axpaul/KinetiCoreDC/Document/KinetiCoreDC_ioc.pdf

03/11/2026

KinetiCoreDC Project
Configuration Report

## 1. Description

### 1.1. Project

Project Name | KinetiCoreDC
Board Name | custom
Generated with: | STM32CubeMX 6.15.0
Date | 11/03/2026

### 1.2. MCU

MCU Series | STM32G0
MCU Line | STM32G0x0 Value line
MCU name | STM32G070CBTx
MCU Package | LQFP48
MCU Pin number | 48

### 1.3. Core(s) information

Core(s) | ARM Cortex-M0+

## 2. Pinout Configuration

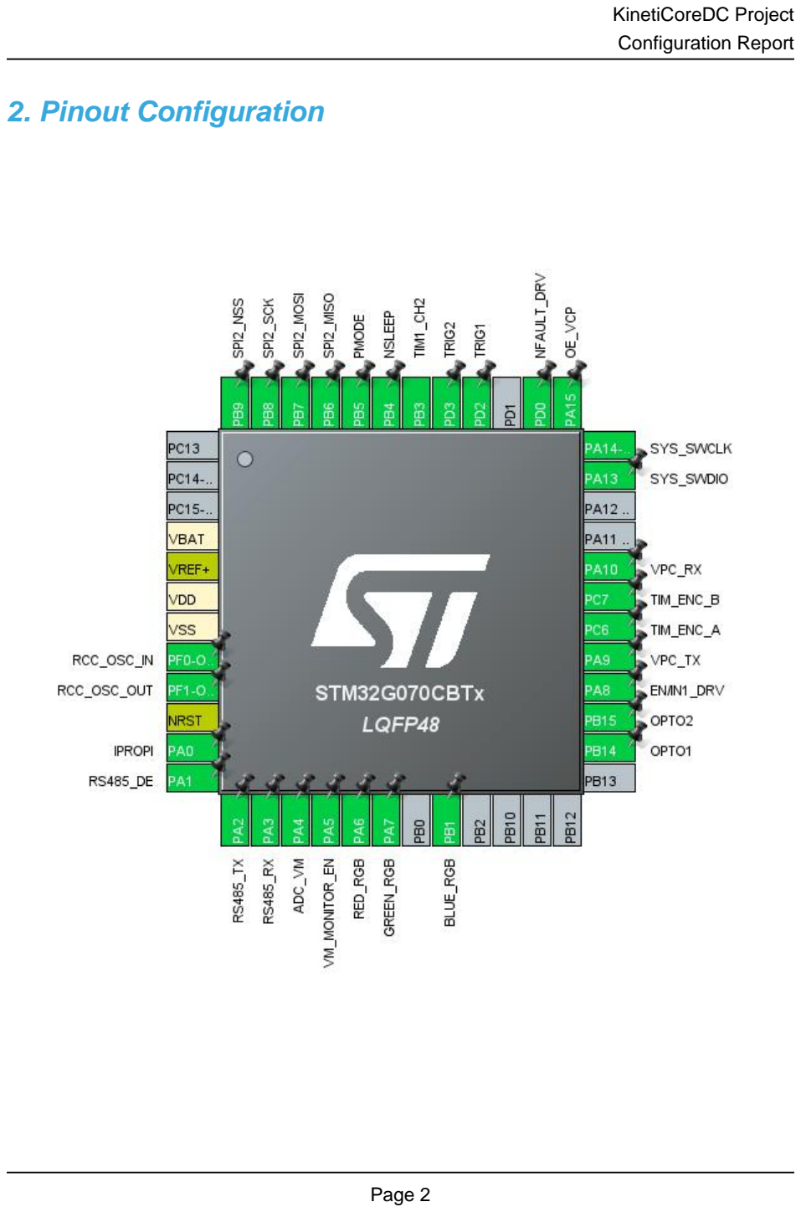
[picture p6: page 3]

## 3. Pins Configuration

Pin Number LQFP48 | Pin Name (function after reset) | Pin Type | Alternate Function(s) | Label
4 | VBAT | Power
5 | VREF+ | MonoIO
6 | VDD | Power
7 | VSS | Power
8 | PF0-OSC_IN (PF0) | I/O | RCC_OSC_IN
9 | PF1-OSC_OUT (PF1) | I/O | RCC_OSC_OUT
10 | NRST | Reset
11 | PA0 | I/O | ADC1_IN0 | IPROPI
12 | PA1 | I/O | USART2_DE | RS485_DE
13 | PA2 | I/O | USART2_TX | RS485_TX
14 | PA3 | I/O | USART2_RX | RS485_RX
15 | PA4 | I/O | ADC1_IN4 | ADC_VM
16 | PA5 * | I/O | GPIO_Output | VM_MONITOR_EN
17 | PA6 | I/O | TIM16_CH1 | RED_RGB
18 | PA7 | I/O | TIM17_CH1 | GREEN_RGB
20 | PB1 | I/O | TIM14_CH1 | BLUE_RGB
26 | PB14 | I/O | TIM15_CH1 | OPTO1
27 | PB15 | I/O | TIM15_CH2 | OPTO2
28 | PA8 | I/O | TIM1_CH1 | EN/IN1_DRV
29 | PA9 | I/O | USART1_TX | VPC_TX
30 | PC6 | I/O | TIM3_CH1 | TIM_ENC_A
31 | PC7 | I/O | TIM3_CH2 | TIM_ENC_B
32 | PA10 | I/O | USART1_RX | VPC_RX
35 | PA13 | I/O | SYS_SWDIO
36 | PA14-BOOT0 | I/O | SYS_SWCLK
37 | PA15 * | I/O | GPIO_Output | OE_VCP
38 | PD0 | I/O | GPIO_EXTI0 | NFAULT_DRV
40 | PD2 | I/O | GPIO_EXTI2 | TRIG1
41 | PD3 | I/O | GPIO_EXTI3 | TRIG2
42 | PB3 | I/O | TIM1_CH2
43 | PB4 * | I/O | GPIO_Output | NSLEEP
44 | PB5 * | I/O | GPIO_Output | PMODE
45 | PB6 | I/O | SPI2_MISO
46 | PB7 | I/O | SPI2_MOSI
47 | PB8 | I/O | SPI2_SCK
48 | PB9 | I/O | SPI2_NSS

* The pin is affected with an I/O function

## 4. Clock Tree Configuration

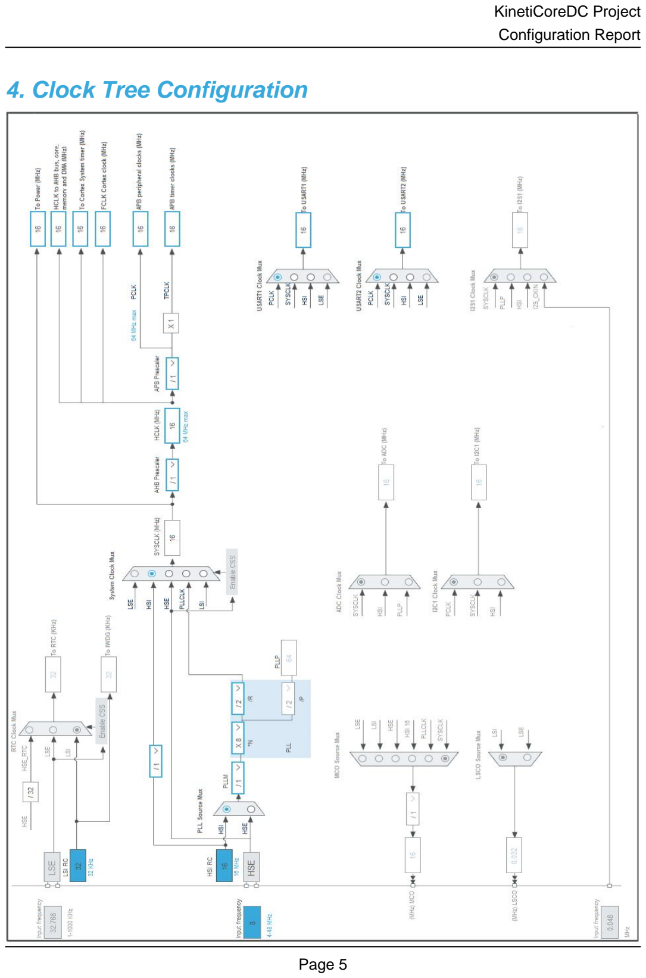
[picture p7: page 6]

## 1. Power Consumption Calculator report

### 1.1. Microcontroller Selection

Series | STM32G0
Line | STM32G0x0 Value line
MCU | STM32G070CBTx
Datasheet | DS12766_Rev0

### 1.2. Parameter Selection

Temperature | 25
Vdd | 3.0

### 1.3. Battery Selection

Battery | Li-SOCL2(AAA700)
Capacity | 700.0 mAh
Self Discharge | 0.08 %/month
Nominal Voltage | 3.6 V
Max Cont Current | 10.0 mA
Max Pulse Current | 30.0 mA
Cells in series | 1
Cells in parallel | 1

### 1.4. Sequence

Step | Step1 | Step2
Mode | RUN | STOP1
Vdd | 3.0 | 3.0
Voltage Source | Battery | Battery
Range | Range1-High | NoRange
Fetch Type | FLASH | Flash-PowerDown
CPU Frequency | 64 MHz | 16 MHz
Clock Configuration | HSI PLL | HSI
Clock Source Frequency | 16 MHz | 16 MHz
Peripherals
Additional Cons. | 0 mA | 0 mA
Average Current | 7.04 mA | 3.74 µA
Duration | 0.1 ms | 0.9 ms
DMIPS | 80.0 | 0.0
Ta Max | 128.42 | 130
Category | In DS Table | In DS Table

### 1.5. Results

Sequence Time | 1 ms | Average Current | 707.37 µA
Battery Life | 1 month, 10 days, 18 hours | Average DMIPS | 80.0 DMIPS

### 1.6. Chart


## 2. Software Project

### 2.1. Project Settings

Name | Value
Project Name | KinetiCoreDC
Project Folder | C:\Users\paulm\OneDrive\Bureau\KinetiCoreDC
Toolchain / IDE | EWARM V8.50
Firmware Package Name and Version | STM32Cube FW_G0 V1.6.3
Application Structure | Advanced
Generate Under Root | No
Do not generate the main() | No
Minimum Heap Size | 0x200
Minimum Stack Size | 0x400

### 2.2. Code Generation Settings

Name | Value
STM32Cube MCU packages and embedded software | Copy all used libraries into the project folder
Generate peripheral initialization as a pair of '.c/.h' files | No
Backup previously generated files when re-generating | No
Keep User Code when re-generating | Yes
Delete previously generated files when not re-generated | Yes
Set all free pins as analog (to optimize the power consumption) | No
Enable Full Assert | No

### 2.3. Advanced Settings - Generated Function Calls

Rank | Function Name | Peripheral Instance Name
1 | SystemClock_Config | RCC
2 | MX_GPIO_Init | GPIO
3 | MX_DMA_Init | DMA
4 | MX_ADC1_Init | ADC1
5 | MX_SPI2_Init | SPI2
6 | MX_TIM1_Init | TIM1
7 | MX_TIM3_Init | TIM3
8 | MX_USART1_UART_Init | USART1
9 | MX_USART2_UART_Init | USART2
10 | MX_TIM14_Init | TIM14
11 | MX_TIM15_Init | TIM15

Rank | Function Name | Peripheral Instance Name
12 | MX_TIM16_Init | TIM16
13 | MX_TIM17_Init | TIM17

## 3. Peripherals and Middlewares Configuration

### 3.1. ADC1

mode: IN0
mode: IN4
3.1.1. Parameter Settings:

ADC_Settings:

Clock Prescaler | Synchronous clock mode divided by 2
Resolution | ADC 12-bit resolution
Data Alignment | Right alignment
Sequencer | Sequencer set to fully configurable
Scan Conversion Mode | Disabled
Continuous Conversion Mode | Disabled
Discontinuous Conversion Mode | Disabled
DMA Continuous Requests | Disabled
End Of Conversion Selection | End of single conversion
Overrun behaviour | Overrun data preserved
Low Power Auto Wait | Disabled
Auto Off | Disabled
Oversampling Mode | Disabled
ADC_Regular_ConversionMode:
SamplingTime Common 1 | 1.5 Cycles
SamplingTime Common 2 | 1.5 Cycles
Number Of Conversion | 1
External Trigger Conversion Source | Regular Conversion launched by software
External Trigger Conversion Edge | None
Trigger Frequency | High frequency
Rank | 1
Channel | Channel 0
Sampling Time | Sampling time common 1
Analog Watchdog 1:
Enable Analog WatchDog1 Mode | false
Analog Watchdog 2:
Enable Analog WatchDog2 Mode | false
Analog Watchdog 3:
Enable Analog WatchDog3 Mode | false

### 3.2. RCC

High Speed Clock (HSE): Crystal/Ceramic Resonator
3.2.1. Parameter Settings:

System Parameters:

VDD voltage (V) | 3.3
Instruction Cache | Enabled
Prefetch Buffer | Enabled
Data Cache | Enabled
Flash Latency(WS) | 0 WS (1 CPU cycle)
RCC Parameters:
HSI Calibration Value | 64
HSE Startup Timout Value (ms) | 100
LSE Startup Timout Value (ms) | 5000
Power Parameters:
Power Regulator Voltage Scale | Power Regulator Voltage Scale 1
Peripherals Clock Configuration:
Generate the peripherals clock configuration | TRUE

### 3.3. SPI2

Mode: Full-Duplex Master
Hardware NSS Signal: Hardware NSS Output Signal
3.3.1. Parameter Settings:

Basic Parameters:

Frame Format | Motorola
Data Size | 4 Bits
First Bit | MSB First
Clock Parameters:
Prescaler (for Baud Rate) | 2
Baud Rate | 8.0 MBits/s *
Clock Polarity (CPOL) | Low
Clock Phase (CPHA) | 1 Edge
Advanced Parameters:
CRC Calculation | Disabled
NSSP Mode | Enabled
NSS Signal Type | Output Hardware

### 3.4. SYS

mode: Debug
Timebase Source: SysTick

### 3.5. TIM1

Trigger Source: ITR0
Channel1: PWM Generation CH1 Channel2: PWM Generation CH2
3.5.1. Parameter Settings:

Counter Settings:

Prescaler (PSC - 16 bits value) | 0
Counter Mode | Up
Counter Period (AutoReload Register - 16 bits value ) | 65535
Internal Clock Division (CKD) | No Division
Repetition Counter (RCR - 16 bits value) | 0
auto-reload preload | Disable
Slave Mode Controller | Slave mode disable
Trigger Output (TRGO) Parameters:
Master/Slave Mode (MSM bit) | Disable (Trigger input effect not delayed)
Trigger Event Selection TRGO | Reset (UG bit from TIMx_EGR)
Trigger Event Selection TRGO2 | Reset (UG bit from TIMx_EGR)
Break And Dead Time management - BRK Configuration:
BRK State | Disable
BRK Polarity | High
BRK Filter (4 bits value) | 0
BRK Sources Configuration
- Digital Input | Disable
Break And Dead Time management - BRK2 Configuration:
BRK2 State | Disable
BRK2 Polarity | High
BRK2 Filter (4 bits value) | 0
BRK2 Sources Configuration
- Digital Input | Disable
Break And Dead Time management - Output Configuration:
Automatic Output State | Disable
Off State Selection for Run Mode (OSSR) | Disable
Off State Selection for Idle Mode (OSSI) | Disable

Lock Configuration | Off
Clear Input:
Clear Input Source | Disable
PWM Generation Channel 1:
Mode | PWM mode 1
Pulse (16 bits value) | 0
Output compare preload | Enable
Fast Mode | Disable
CH Polarity | High
CH Idle State | Reset
PWM Generation Channel 2:
Mode | PWM mode 1
Pulse (16 bits value) | 0
Output compare preload | Enable
Fast Mode | Disable
CH Polarity | High
CH Idle State | Reset

### 3.6. TIM3

Combined Channels: Encoder Mode
3.6.1. Parameter Settings:

Counter Settings:

Prescaler (PSC - 16 bits value) | 0
Counter Mode | Up
Counter Period (AutoReload Register - 16 bits value ) | 65535
Internal Clock Division (CKD) | No Division
auto-reload preload | Disable
Trigger Output (TRGO) Parameters:
Master/Slave Mode (MSM bit) | Disable (Trigger input effect not delayed)
Trigger Event Selection TRGO | Reset (UG bit from TIMx_EGR)
Encoder:
Encoder Mode | Encoder Mode TI1
____ Parameters for Channel 1 ____
Polarity | Rising Edge
IC Selection | Direct
Prescaler Division Ratio | No division
Input Filter | 0
____ Parameters for Channel 2 ____
Polarity | Rising Edge

IC Selection | Direct
Prescaler Division Ratio | No division
Input Filter | 0

### 3.7. TIM14

mode: Activated
Channel1: PWM Generation CH1
3.7.1. Parameter Settings:

Counter Settings:

Prescaler (PSC - 16 bits value) | 0
Counter Mode | Up
Counter Period (AutoReload Register - 16 bits value ) | 65535
Internal Clock Division (CKD) | No Division
auto-reload preload | Disable
PWM Generation Channel 1:
Mode | PWM mode 1
Pulse (16 bits value) | 0
Output compare preload | Enable
Fast Mode | Disable
CH Polarity | High

### 3.8. TIM15

Channel1: Input Capture direct mode Channel2: Input Capture direct mode
3.8.1. Parameter Settings:

Counter Settings:

Prescaler (PSC - 16 bits value) | 0
Counter Mode | Up
Counter Period (AutoReload Register - 16 bits value ) | 65535
Internal Clock Division (CKD) | No Division
Repetition Counter (RCR - 8 bits value) | 0
auto-reload preload | Disable
Trigger Output (TRGO) Parameters:
Master/Slave Mode (MSM bit) | Disable (Trigger input effect not delayed)
Trigger Event Selection | Reset (UG bit from TIMx_EGR)

Input Capture Channel 1:

Polarity Selection | Rising Edge
IC Selection | Direct
Prescaler Division Ratio | No division
Input Filter (4 bits value) | 0
Input Capture Channel 2:
Polarity Selection | Rising Edge
IC Selection | Direct
Prescaler Division Ratio | No division
Input Filter (4 bits value) | 0

### 3.9. TIM16

mode: Activated
Channel1: PWM Generation CH1
3.9.1. Parameter Settings:

Counter Settings:

Prescaler (PSC - 16 bits value) | 0
Counter Mode | Up
Counter Period (AutoReload Register - 16 bits value ) | 65535
Internal Clock Division (CKD) | No Division
Repetition Counter (RCR - 8 bits value) | 0
auto-reload preload | Disable
Break And Dead Time management - BRK Configuration:
BRK State | Disable
BRK Polarity | High
BRK Filter (4 bits value) | 0
BRK Sources Configuration
- Digital Input | Disable
Break And Dead Time management - Output Configuration:
Automatic Output State | Disable
Off State Selection for Run Mode (OSSR) | Disable
Off State Selection for Idle Mode (OSSI) | Disable
Lock Configuration | Off
PWM Generation Channel 1:
Mode | PWM mode 1
Pulse (16 bits value) | 0
Output compare preload | Enable
Fast Mode | Disable

CH Polarity | High
CH Idle State | Reset

### 3.10. TIM17

mode: Activated
Channel1: PWM Generation CH1
3.10.1. Parameter Settings:

Counter Settings:

Prescaler (PSC - 16 bits value) | 0
Counter Mode | Up
Counter Period (AutoReload Register - 16 bits value ) | 65535
Internal Clock Division (CKD) | No Division
Repetition Counter (RCR - 8 bits value) | 0
auto-reload preload | Disable
Break And Dead Time management - BRK Configuration:
BRK State | Disable
BRK Polarity | High
BRK Filter (4 bits value) | 0
BRK Sources Configuration
- Digital Input | Disable
Break And Dead Time management - Output Configuration:
Automatic Output State | Disable
Off State Selection for Run Mode (OSSR) | Disable
Off State Selection for Idle Mode (OSSI) | Disable
Lock Configuration | Off
PWM Generation Channel 1:
Mode | PWM mode 1
Pulse (16 bits value) | 0
Output compare preload | Enable
Fast Mode | Disable
CH Polarity | High
CH Idle State | Reset

### 3.11. USART1

Mode: Asynchronous
3.11.1. Parameter Settings:

Basic Parameters:

Baud Rate | 115200
Word Length | 8 Bits (including Parity)
Parity | None
Stop Bits | 1
Advanced Parameters:
Data Direction | Receive and Transmit
Over Sampling | 16 Samples
Single Sample | Disable
ClockPrescaler | 1
Fifo Mode | Disable
Txfifo Threshold | 1 eighth full configuration
Rxfifo Threshold | 1 eighth full configuration
Advanced Features:
Auto Baudrate | Disable
TX Pin Active Level Inversion | Disable
RX Pin Active Level Inversion | Disable
Data Inversion | Disable
TX and RX Pins Swapping | Disable
Overrun | Enable
DMA on RX Error | Enable
MSB First | Disable

### 3.12. USART2

Mode: Asynchronous
mode: Hardware Flow Control (RS485)
3.12.1. Parameter Settings:

Basic Parameters:

Baud Rate | 115200
Word Length | 8 Bits (including Parity)
Parity | None
Stop Bits | 1
Advanced Parameters:
Data Direction | Receive and Transmit
Over Sampling | 16 Samples
Single Sample | Disable
ClockPrescaler | 1

Fifo Mode | Disable
Txfifo Threshold | 1 eighth full configuration
Rxfifo Threshold | 1 eighth full configuration
Polarity | High
Assertion Time | 0
Deassertion Time | 0
Advanced Features:
Auto Baudrate | Disable
TX Pin Active Level Inversion | Disable
RX Pin Active Level Inversion | Disable
Data Inversion | Disable
TX and RX Pins Swapping | Disable
Overrun | Enable
DMA on RX Error | Enable
MSB First | Disable

* User modified value

## 4. System Configuration

### 4.1. GPIO configuration

IP | Pin | Signal | GPIO mode | GPIO pull/up pull down | Max Speed | User Label
ADC1 | PA0 | ADC1_IN0 | Analog mode | No pull-up and no pull-down | n/a | IPROPI
| PA4 | ADC1_IN4 | Analog mode | No pull-up and no pull-down | n/a | ADC_VM
RCC | PF0-OSC_IN (PF0) | RCC_OSC_IN | n/a | n/a | n/a
| PF1-OSC_OUT (PF1) | RCC_OSC_OUT | n/a | n/a | n/a
SPI2 | PB6 | SPI2_MISO | Alternate Function Push Pull | No pull-up and no pull-down | Low
| PB7 | SPI2_MOSI | Alternate Function Push Pull | No pull-up and no pull-down | Low
| PB8 | SPI2_SCK | Alternate Function Push Pull | No pull-up and no pull-down | Low
| PB9 | SPI2_NSS | Alternate Function Push Pull | No pull-up and no pull-down | Low
SYS | PA13 | SYS_SWDIO | n/a | n/a | n/a
| PA14-BOOT0 | SYS_SWCLK | n/a | n/a | n/a
TIM1 | PA8 | TIM1_CH1 | Alternate Function Push Pull | No pull-up and no pull-down | Low | EN/IN1_DRV
| PB3 | TIM1_CH2 | Alternate Function Push Pull | No pull-up and no pull-down | Low
TIM3 | PC6 | TIM3_CH1 | Alternate Function Push Pull | No pull-up and no pull-down | Low | TIM_ENC_A
| PC7 | TIM3_CH2 | Alternate Function Push Pull | No pull-up and no pull-down | Low | TIM_ENC_B
TIM14 | PB1 | TIM14_CH1 | Alternate Function Push Pull | No pull-up and no pull-down | Low | BLUE_RGB
TIM15 | PB14 | TIM15_CH1 | Alternate Function Push Pull | No pull-up and no pull-down | Low | OPTO1
| PB15 | TIM15_CH2 | Alternate Function Push Pull | No pull-up and no pull-down | Low | OPTO2
TIM16 | PA6 | TIM16_CH1 | Alternate Function Push Pull | No pull-up and no pull-down | Low | RED_RGB
TIM17 | PA7 | TIM17_CH1 | Alternate Function Push Pull | No pull-up and no pull-down | Low | GREEN_RGB
USART1 | PA9 | USART1_TX | Alternate Function Push Pull | No pull-up and no pull-down | Low | VPC_TX
| PA10 | USART1_RX | Alternate Function Push Pull | No pull-up and no pull-down | Low | VPC_RX
USART2 | PA1 | USART2_DE | Alternate Function Push Pull | No pull-up and no pull-down | Low | RS485_DE
| PA2 | USART2_TX | Alternate Function Push Pull | No pull-up and no pull-down | Low | RS485_TX
| PA3 | USART2_RX | Alternate Function Push Pull | No pull-up and no pull-down | Low | RS485_RX
GPIO | PA5 | GPIO_Output | Output Push Pull | No pull-up and no pull-down | Low | VM_MONITOR_EN
| PA15 | GPIO_Output | Output Push Pull | No pull-up and no pull-down | Low | OE_VCP
| PD0 | GPIO_EXTI0 | External Interrupt Mode with Rising edge trigger detection | No pull-up and no pull-down | n/a | NFAULT_DRV
| PD2 | GPIO_EXTI2 | External Interrupt Mode with Rising edge trigger detection | No pull-up and no pull-down | n/a | TRIG1
| PD3 | GPIO_EXTI3 | External Interrupt Mode with Rising edge trigger detection | No pull-up and no pull-down | n/a | TRIG2
| PB4 | GPIO_Output | Output Push Pull | No pull-up and no pull-down | Low | NSLEEP
| PB5 | GPIO_Output | Output Push Pull | No pull-up and no pull-down | Low | PMODE

### 4.2. DMA configuration

DMA request | Stream | Direction | Priority
USART2_RX | DMA1_Channel1 | Peripheral To Memory | Low

USART2_RX: DMA1_Channel1 DMA request Settings:

Mode: | Normal
Peripheral Increment: | Disable
Memory Increment: | Enable *
Peripheral Data Width: | Word *
Memory Data Width: | Word *

### 4.3. NVIC configuration

4.3.1. NVIC
Interrupt Table | Enable | Preenmption Priority | SubPriority
Non maskable interrupt | true | 0 | 0
Hard fault interrupt | true | 0 | 0
System service call via SWI instruction | true | 0 | 0
Pendable request for system service | true | 0 | 0
System tick timer | true | 3 | 0
EXTI line 0 and line 1 interrupts | true | 0 | 0
EXTI line 2 and line 3 interrupts | true | 1 | 0
DMA1 channel 1 interrupt | true | 0 | 0
TIM15 global interrupt | true | 2 | 0
USART2 global interrupt / USART2 wake-up interrupt through EXTI line 26 | true | 1 | 0
Flash global interrupt | | unused
RCC global interrupt | | unused
ADC1 interrupt | | unused
TIM1 break, update, trigger and commutation interrupts | | unused
TIM1 capture compare interrupt | | unused
TIM3 global interrupt | | unused
TIM14 global interrupt | | unused
TIM16 global interrupt | | unused
TIM17 global interrupt | | unused
SPI2 global interrupt | | unused
USART1 global interrupt / USART1 wake-up interrupt through EXTI line 25 | | unused
4.3.2. NVIC Code generation

Enabled interrupt Table Select for init
sequence ordering
| | Generate IRQ
| | handler | Call HAL handler
Non maskable interrupt | false | true | false
Hard fault interrupt | false | true | false
System service call via SWI instruction | false | true | false
Pendable request for system service | false | true | false
System tick timer | false | true | true
EXTI line 0 and line 1 interrupts | false | true | true
EXTI line 2 and line 3 interrupts | false | true | true
DMA1 channel 1 interrupt | false | true | true
TIM15 global interrupt | false | true | true
USART2 global interrupt / USART2 wake- | false | true | true

Enabled interrupt Table | Select for init sequence ordering | Generate IRQ handler | Call HAL handler

up interrupt through EXTI line 26

* User modified value

## 5. System Views

5.1. Category view
5.1.1. Current


## 6. Docs & Resources

Type | Link
IBIS models | https://www.st.com/resource/en/ibis_model/stm32g0_ibis.zip
System View Description | https://www.st.com/resource/en/svd/stm32g0-svd.zip
Presentations | https://www.st.com/resource/en/product_presentation/stm32-stm8_embedded_software_solutions.pdf
Presentations | https://www.st.com/resource/en/product_presentation/stm32_eval-tools_portfolio.pdf
Presentations | https://www.st.com/resource/en/product_presentation/stm32_stm8_functi onal-safety-packages.pdf
Presentations | https://www.st.com/resource/en/product_presentation/stm32g0_marketing_pres.pdf
Presentations | https://www.st.com/resource/en/product_presentation/stm32-usb-c-pd-solutions-presentation.pdf
Presentations | https://www.st.com/resource/en/product_presentation/stm32-stm8_software_development_tools.pdf
Presentations | https://www.st.com/resource/en/product_presentation/microcontrollers-stm32-family-overview.pdf
Presentations | https://www.st.com/resource/en/product_presentation/microcontrollers-stm32-entry-level-graphics.pdf
Brochures | https://www.st.com/resource/en/brochure/humanoid-robot-reference-guide.pdf
Flyers | https://www.st.com/resource/en/flyer/flstm32g0.pdf
Flyers | https://www.st.com/resource/en/flyer/flstm32nucleo.pdf
Flyers | https://www.st.com/resource/en/flyer/flstm32trust.pdf
Flyers | https://www.st.com/resource/en/flyer/flstm32c5.pdf
Security Bulletin | https://www.st.com/resource/en/technical_note/tn1489-security-bulletin-tn1489stpsirt-physical-attacks-on-stm32-and-stm32cube-firmware-stmicroelectronics.pdf
Application Notes | https://www.st.com/resource/en/application_note/an1709-emc-design-

| guide-for-stm8-stm32-and-legacy-mcus-stmicroelectronics.pdf
Application Notes | https://www.st.com/resource/en/application_note/an4221-i2c-protocol-used-in-the-stm32-bootloader-stmicroelectronics.pdf
Application Notes | https://www.st.com/resource/en/application_note/an4655-virtually-increasing-the-number-of-serial-communication-peripherals-in-stm32-applications-stmicroelectronics.p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
Application Notes | https://www.st.com/resource/en/application_note/an4750-handling-of-soft-errors-in-stm32-applications-stmicroelectronics.pdf
Application Notes | https://www.st.com/resource/en/application_note/an4803-highspeed-si-simulations-using-ibis-and-boardlevel-simulations-using-hyperlynx-si-on-stm32-mcus-and-mpus-stmic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
Application Notes | https://www.st.com/resource/en/application_note/an5027-interfacing-pdm-digital-microphones-using-stm32-mcus-and-mpus-stmicroelectronics.pdf
Application Notes | https://www.st.com/resource/en/application_note/an5110-stm32cube-firmware-examples-for-stm32g0-series-stmicroelectronics.pdf
Application Notes | https://www.st.com/resource/en/application_note/an5145-migration-of-applications-from-stm32f0-series-to-stm32g0-series--stmicroelectronics.pdf
Application Notes | https://www.st.com/resource/en/application_note/an4899-stm32-microcontroller-gpio-hardware-settings-and-lowpower-consumption-stmicroelectronics.pdf
Application Notes | https://www.st.com/resource/en/application_note/an5612-esd-protection-of-stm32-mcus-and-mpus-stmicroelectronics.pdf
Application Notes | https://www.st.com/resource/en/application_note/an4991-how-to-wake-up-an-stm32-microcontroller-from-lowpower-mode-with-the-usart-or-the-lpuart-stmicroelectronics.pdf
Application Notes | https://www.st.com/resource/en/application_note/an4838-introduction-to-memory-protection-unit-management-on-stm32-mcus-stmicroelectronics.pdf
Application Notes | https://www.st.com/resource/en/application_note/an5225-introduction-to-usb-typec-power-delivery-for-stm32-mcus-and-mpus-stmicroelectronics.pdf
Application Notes | https://www.st.com/resource/en/application_note/an4777-how-to-

| optimize-power-consumption-on-stm32-mcus-stmicroelectronics.pdf
Application Notes | https://www.st.com/resource/en/application_note/an4894-how-to-use-eeprom-emulation-on-stm32-mcus-stmicroelectronics.pdf
Application Notes | https://www.st.com/resource/en/application_note/an5537-how-to-use-adc-oversampling-techniques-to-improve-signaltonoise-ratio-on-stm32-mcus-stmicroelectronics.pdf
Application Notes | https://www.st.com/resource/en/application_note/an5405-how-to-use-fdcan-bootloader-protocol-on-stm32-mcus-stmicroelectronics.pdf
Application Notes | https://www.st.com/resource/en/application_note/an5690-how-to-use-vrefbuf-peripheral-on-stm32-mcus-and-mpus-stmicroelectronics.pdf
Application Notes | https://www.st.com/resource/en/application_note/an4230-introduction-to-random-number-generation-validation-using-the-nist-statistical-test-suite-for-stm32-mcus-and-m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
Application Notes | https://www.st.com/resource/en/application_note/an2548-introduction-to-dma-controller-for-stm32-mcus-stmicroelectronics.pdf
Application Notes | https://www.st.com/resource/en/application_note/an4013-introduction-to-timers-for-stm32-mcus-stmicroelectronics.pdf
Application Notes | https://www.st.com/resource/en/application_note/an4277-how-to-use-pwm-shutdown-for-motor-control-and-digital-power-conversion-on-stm32-mcus-stmicroelectronics.pdf
Application Notes | https://www.st.com/resource/en/application_note/an4635-how-to-optimize-lpuart-power-consumption-on-stm32-mcus-stmicroelectronics.pdf
Application Notes | https://www.st.com/resource/en/application_note/an4908-getting-started-with-usart-automatic-baud-rater-detection-for-stm32-mcus-stmicroelectronics.pdf
Application Notes | https://www.st.com/resource/en/application_note/an5156-introduction-to-security-for-stm32-mcus-stmicroelectronics.pdf
Application Notes | https://www.st.com/resource/en/application_note/an5224-introduction-to-dmamux-for-stm32-mcus-stmicroelectronics.pdf
Application Notes | https://www.st.com/resource/en/application_note/an5543-guidelines-for-enhanced-spi-communication-on-stm32-mcus-and-mpus-stmicroelectronics.pdf

Application Notes | https://www.st.com/resource/en/application_note/an5348-introduction-to-fdcan-peripherals-for-stm32-mcus-stmicroelectronics.pdf
Application Notes | https://www.st.com/resource/en/application_note/an5969-migrating-between-stm32g0-and-stm32c0-mcus-stmicroelectronics.pdf
Application Notes | https://www.st.com/resource/en/application_note/cd00211314-how-to-optimize-the-adc-accuracy-in-the-stm32-mcus-stmicroelectronics.pdf
Application Notes | https://www.st.com/resource/en/application_note/an2639-soldering-recommendations-and-package-information-for-leadfree-ecopack2-mcus-and-mpus-stmicroelectronics.pdf
Application Notes | https://www.st.com/resource/en/application_note/an6226-migrating-between-stm32g0-and-stm32u0-mcus-stmicroelectronics.pdf
Application Notes | https://www.st.com/resource/en/application_note/an4566-how-to-extend-the-dac-performance-on-stm32-mcus-stmicroelectronics.pdf
Application Notes | https://www.st.com/resource/en/application_note/an5647-the-goertzel-algorithm-to-compute-individual-terms-of-the-discrete-fourier-transform-dft-in-stm32-products-stm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
Application Notes | https://www.st.com/resource/en/application_note/an2606-introduction-to-system-memory-boot-mode-on-stm32-mcus-stmicroelectronics.pdf
Application Notes | https://www.st.com/resource/en/application_note/an5096-getting-started-with-stm32g0-mcus-hardware-development-stmicroelectronics.pdf
Application Notes | https://www.st.com/resource/en/application_note/an5036-guidelines-for-thermal-management-on-stm32-mcus-and-mpus-stmicroelectronics.pdf
Application Notes | https://www.st.com/resource/en/application_note/an3126-how-to-use-dac-for-audio-and-waveform-generation-on-stm32-mcus-and-mpus-stmicroelectronics.pdf
Application Notes | https://www.st.com/resource/en/application_note/an3155-how-to-use-usart-protocol-in-bootloader-on-stm32-mcus-stmicroelectronics.pdf
Application Notes | https://www.st.com/resource/en/application_note/an3156-how-to-use-usb-dfu-protocol-in-bootloader-on-stm32-mcus-stmicroelectronics.pdf
Application Notes | https://www.st.com/resource/en/application_note/an4286-how-to-use-spi-protocol-in-bootloader-on-stm32-mcus-stmicroelectronics.pdf
Application Notes | https://www.st.com/resource/en/application_note/an4759-introduction-to- using-the-hardware-realtime-clock-rtc-and-the-tamper-management-unit-

| tamp-for-stm32-mcus-stmicroelectronics.pdf
Application Notes | https://www.st.com/resource/en/application_note/an4776-how-to-use-generalpurpose-timer-peripheral-on-stm32-mcus-stmicroelectronics.pdf
Application Notes | https://www.st.com/resource/en/application_note/an4989-introduction-to-debug-toolbox-for-stm32-mcus-stmicroelectronics.pdf
Application Notes | https://www.st.com/resource/en/application_note/an6363-introduction-to-clock-requirements-and-calibration-for-stm32-mcus-stmicroelectronics.pdf
Errata Sheets | https://www.st.com/resource/en/errata_sheet/es0468-stm32g070cbkbrb-device-errata-stmicroelectronics.pdf
Datasheet | https://www.st.com/resource/en/datasheet/dm00542744.pdf
Programming Manuals | https://www.st.com/resource/en/programming_manual/pm0223-stm32-cortexm0-mcus-programming-manual-stmicroelectronics.pdf
Reference Manuals | https://www.st.com/resource/en/reference_manual/rm0454-stm32g0x0-advanced-armbased-32bit-mcus-stmicroelectronics.pdf
Technical Notes & Articles | https://www.st.com/resource/en/technical_note/tn1163-description-of-wlcsp-for-microcontrollers-and-recommendations-for-its-use-stmicroelectronics.pdf
Technical Notes & Articles | https://www.st.com/resource/en/technical_note/tn1205-tape-and-reel-shipping-media-for-stm8-and-stm32-microcontrollers-in-fpn-packages-stmicroelectronics.pdf
Technical Notes & Articles | https://www.st.com/resource/en/technical_note/tn1206-tape-and-reel-shipping-media-for-stm8-and-stm32-microcontrollers-in-qfp-packages-stmicroelectronics.pdf
Technical Notes & Articles | https://www.st.com/resource/en/technical_note/tn1207-tape-and-reel-shipping-media-for-stm8-and-stm32-microcontrollers-in-so-packages-stmicroelectronics.pdf
Technical Notes & Articles | https://www.st.com/resource/en/technical_note/tn1208-tape-and-reel-shipping-media-for-stm8-and-stm32-microcontrollers-in-tssop-and-ssop-packages-stmicroelectronics.p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
Technical Notes & Articles | https://www.st.com/resource/en/technical_note/tn1433-reference-device-marking-schematics-for-stm32-microcontrollers-and-microprocessors-stmicroelectronics.pdf
Technical Notes | https://www.st.com/resource/en/technical_note/tn1204-tape-and-reel-

& Articles | shipping-media-for-stm32-devices-in-bga-packages-stmicroelectronics.pdf
User Manuals | https://www.st.com/resource/en/user_manual/um3083-stm32g0-series-iec-60730-selftest-library-user-guide-stmicroelectronics.pdf
