axpaul/KinetiCoreDC/Schematic/KinetiCoreDC-PowerSheet.pdf

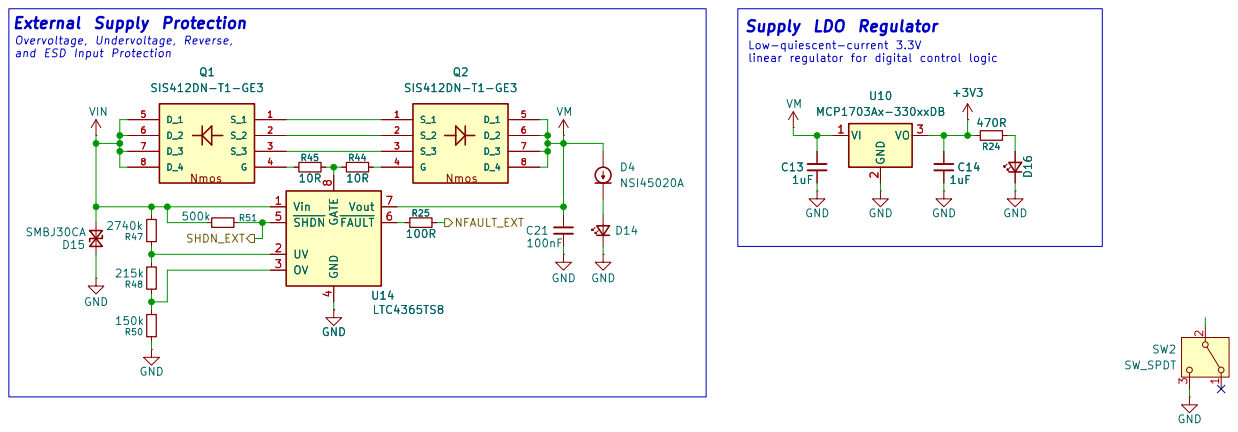
[picture p8: page 1]

linear regulator for digital control logic U14

Size: A4 | Author : | Rev:
KiCad E.D.A. 10.0.2 | | Id: 4/4
