axpaul/KinetiCoreDC/Schematic/KinetiCoreDC.pdf

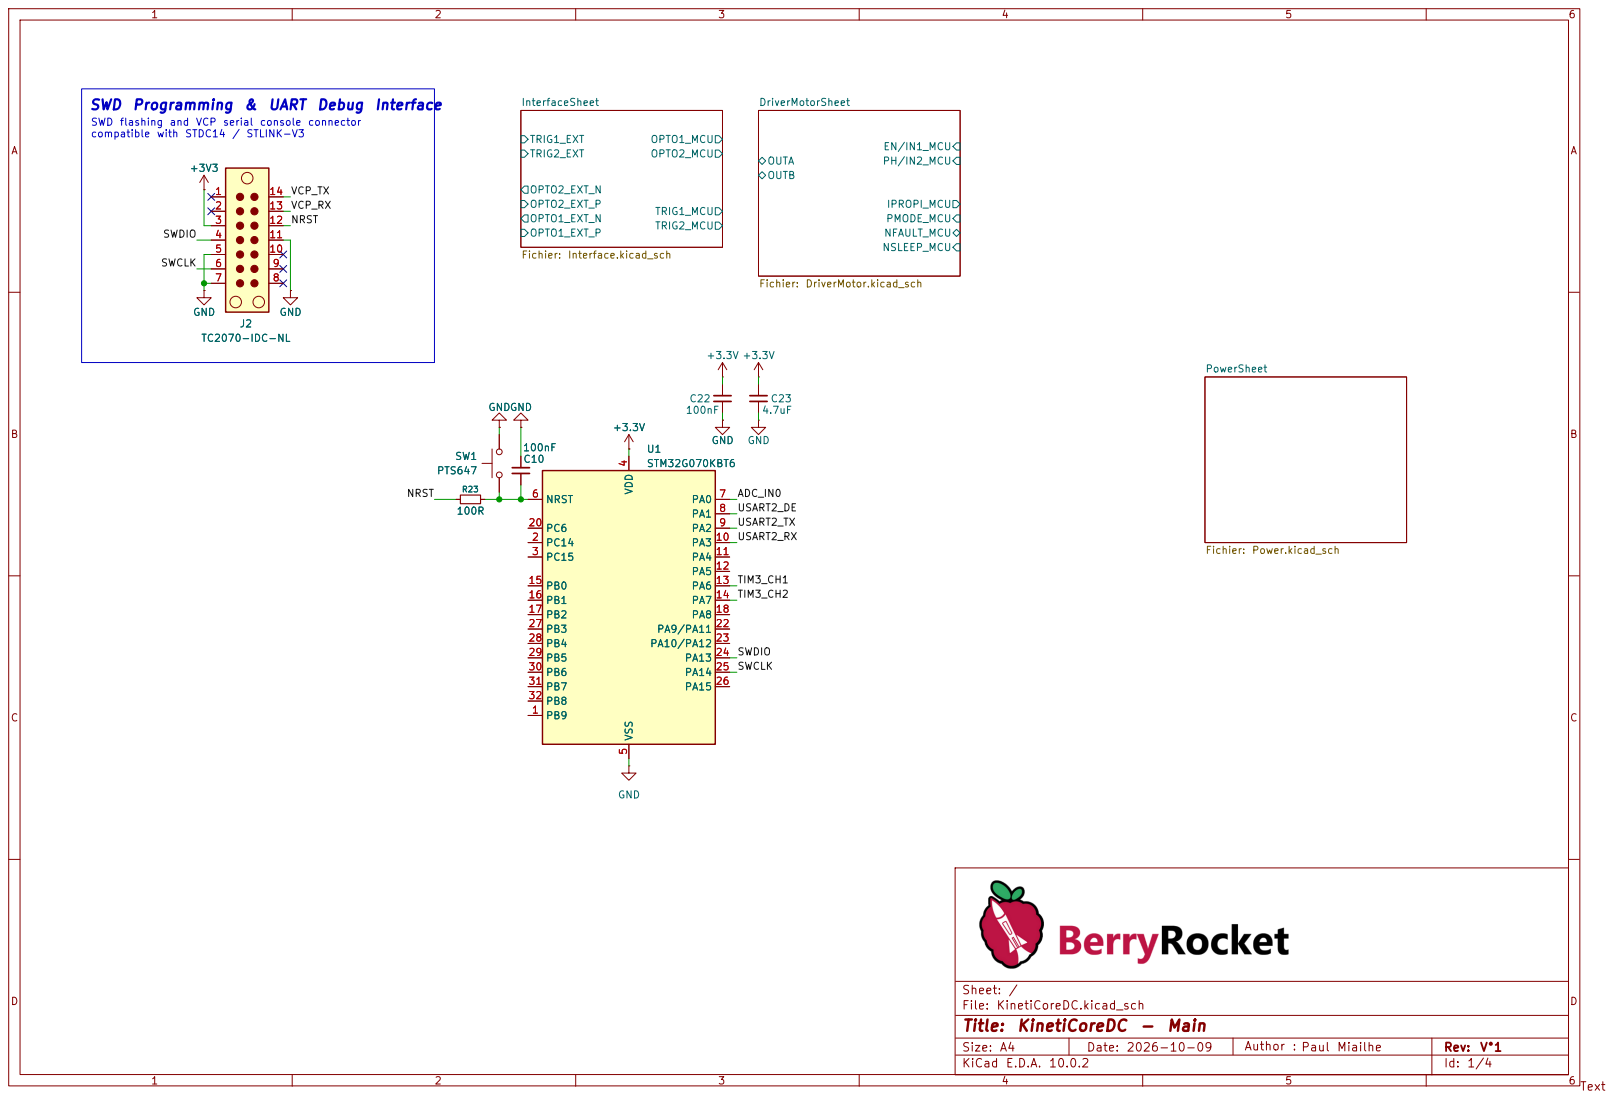
[picture p9: page 1]

InterfaceSheet Fichier: Interface.kicad_sch GND

SWD flashing and VCP serial console connector compatible with STDC14 / STLINK-V3 SWD Programming & UART Debug Interface

Size: A4 | Author : Paul Miailhe | Rev: V°1
KiCad E.D.A. 10.0.2 | | Id: 1/4

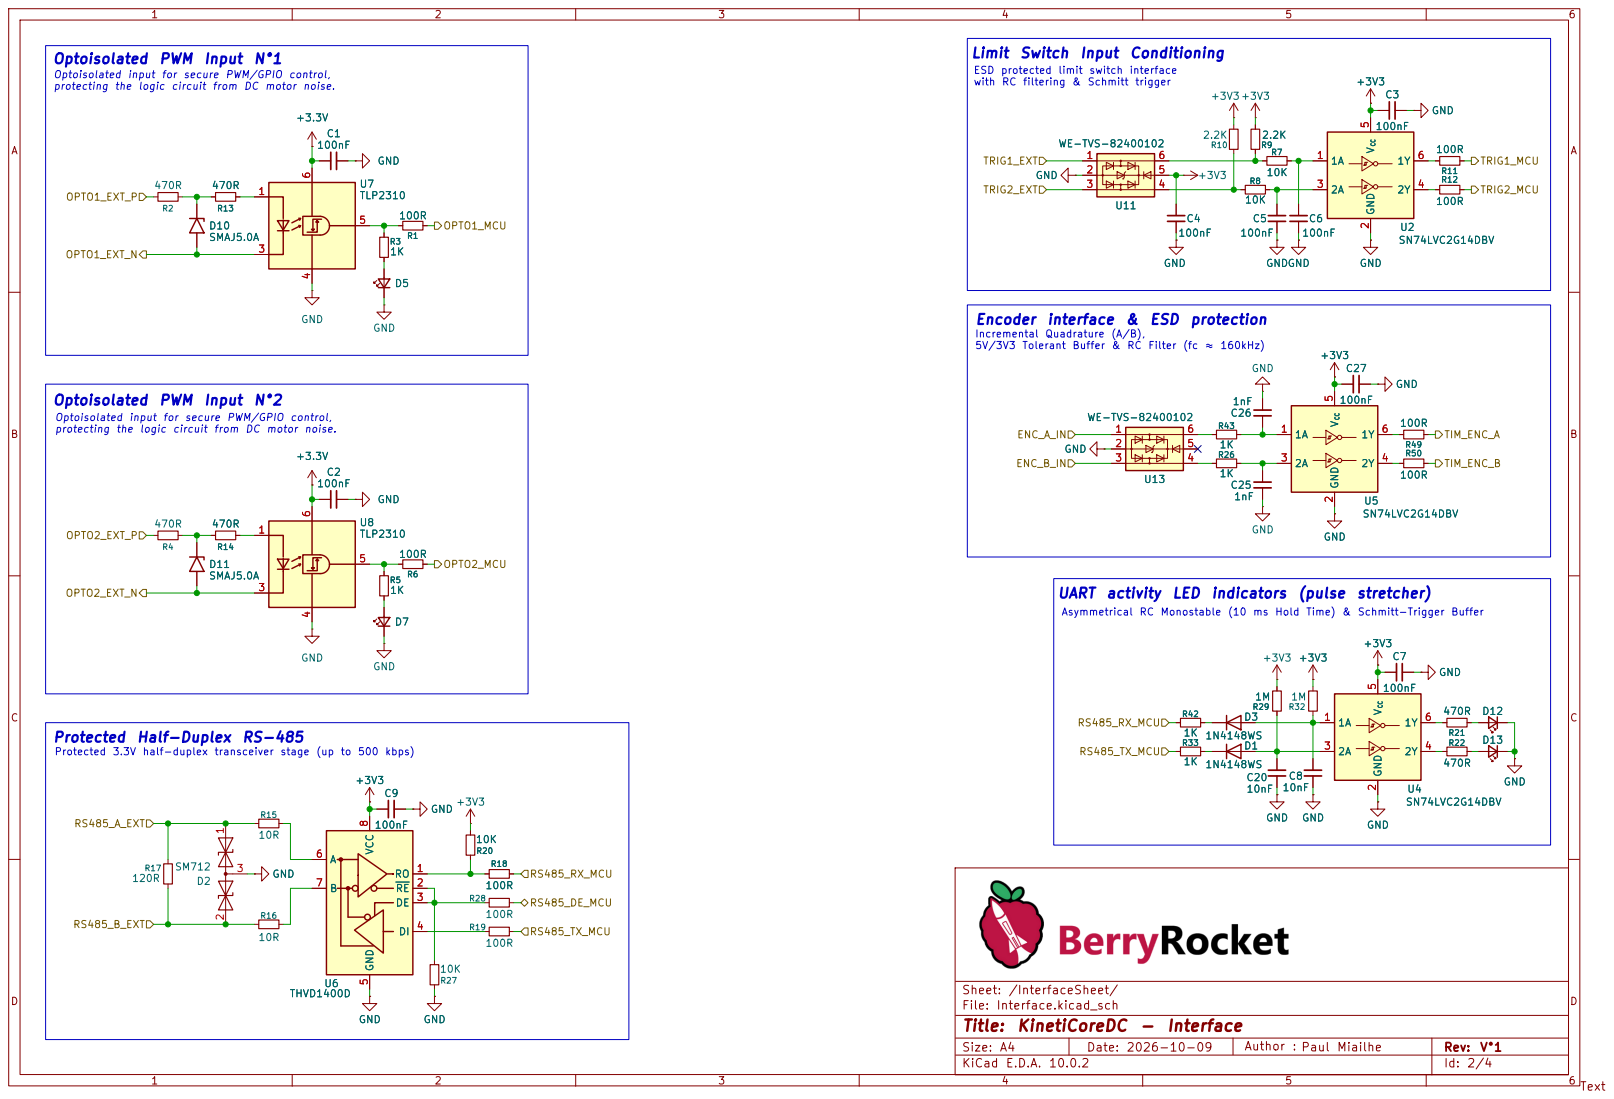
[picture p10: page 2]

Limit Switch Input Conditioning Optoisolated PWM Input N°1
Optoisolated input for secure PWM/GPIO control,

Asymmetrical RC Monostable (10 ms Hold Time) & Schmitt-Trigger Buffer Encoder interface & ESD protection

Incremental Quadrature (A/B),
5V/3V3 Tolerant Buffer & RC Filter (fc ≈ 160kHz)

Optoisolated PWM Input N°2
protecting the logic circuit from DC motor noise.

Protected Half-Duplex RS-485

Protected 3.3V half-duplex transceiver stage (up to 500 kbps)

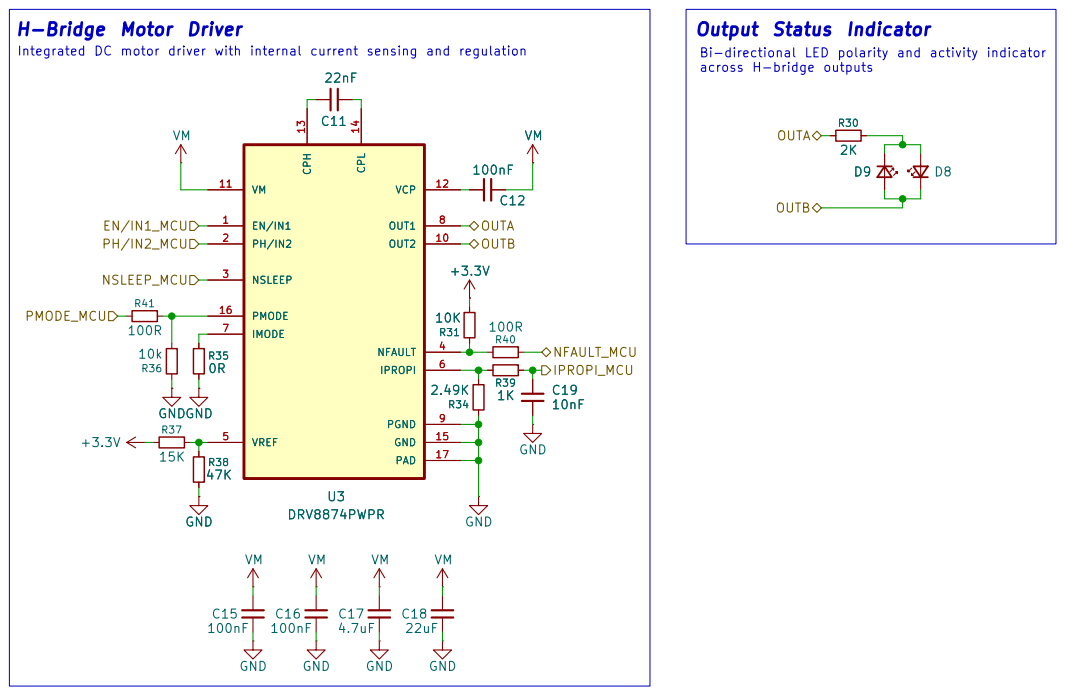
[picture p11: page 3]

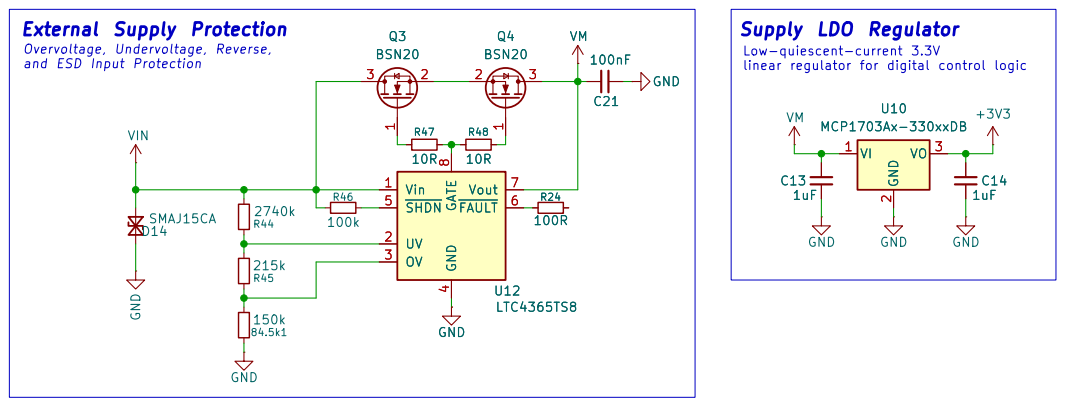
[picture p12: page 4]

Low-quiescent-current 3.3V
linear regulator for digital control logic C13
