axpaul/KinetiCoreDC/Document/KinetiCoreDC.pdf

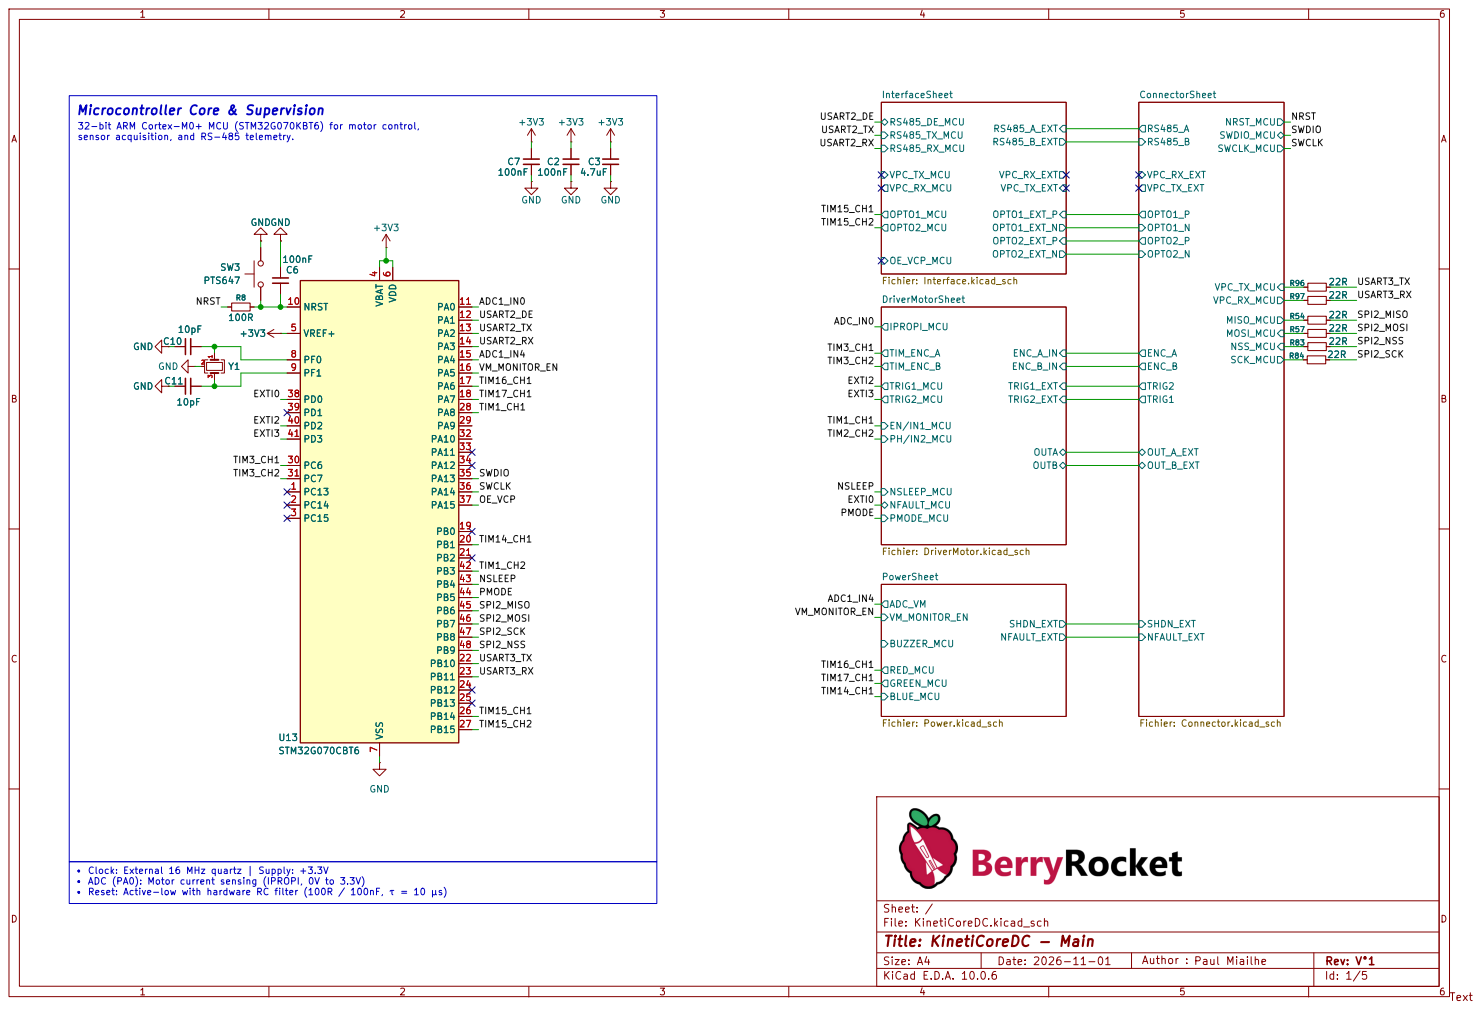
[picture p13: page 1]

Microcontroller Core & Supervision
32-bit ARM Cortex-M0+ MCU (STM32G070KBT6) for motor control, sensor acquisition, and RS-485 telemetry. U13

Size: A4 | Author : Paul Miailhe | Rev: V°1
KiCad E.D.A. 10.0.6 | | Id: 1/5

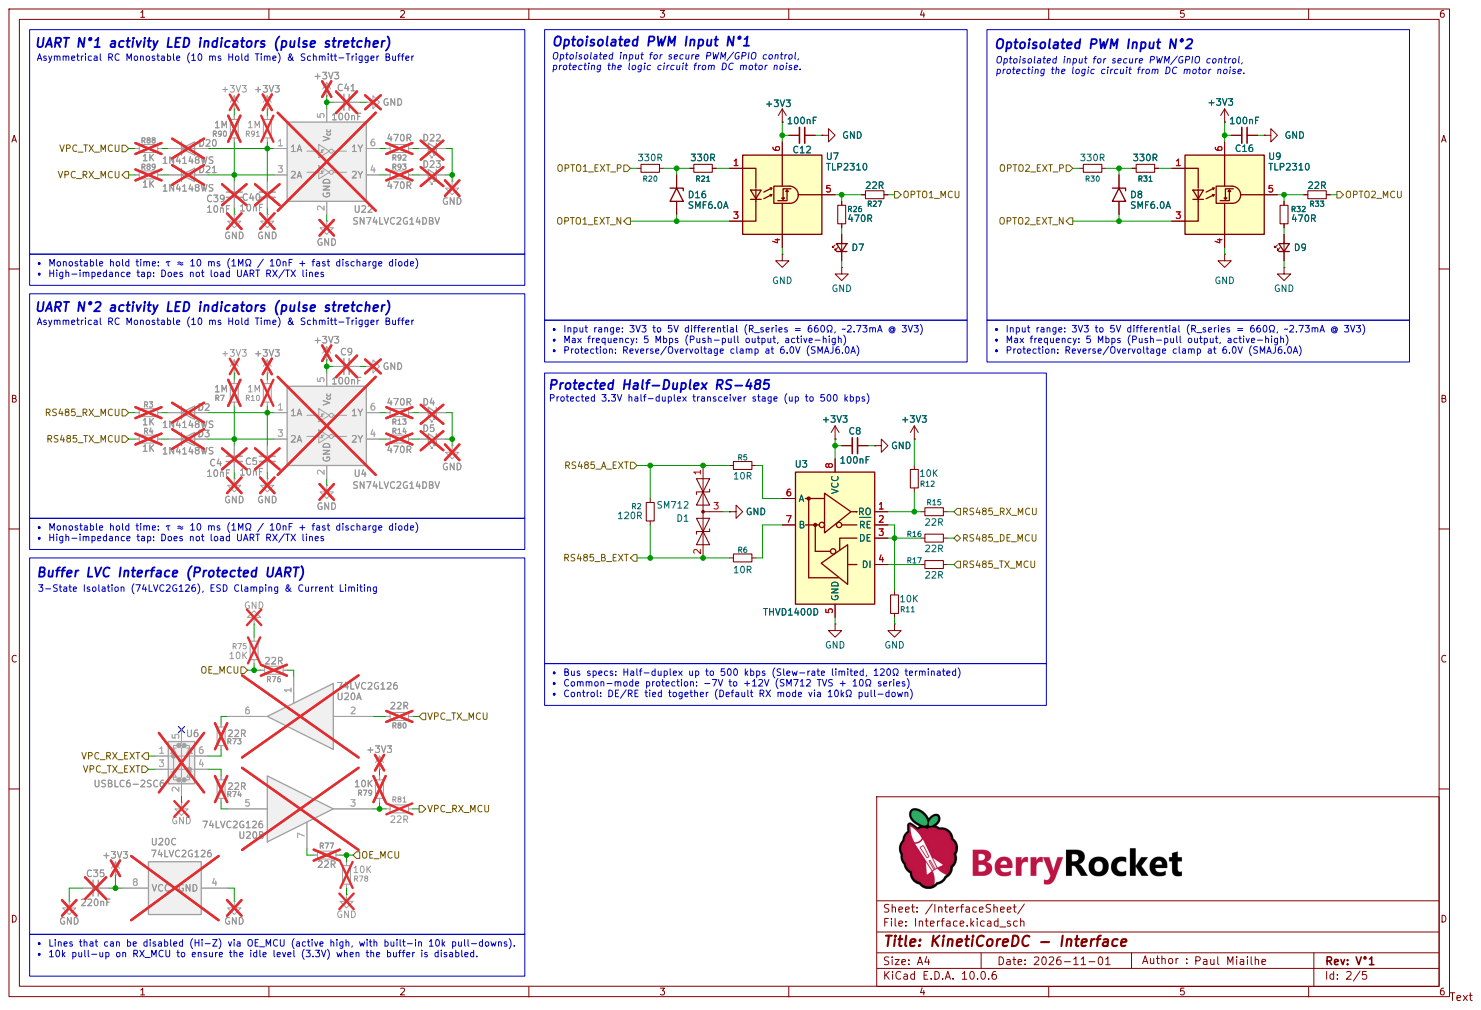
[picture p14: page 2]

protecting the logic circuit from DC motor noise. Asymmetrical RC Monostable (10 ms Hold Time) & Schmitt-Trigger Buffer UART N°1 activity LED indicators (pulse stretcher)

Optoisolated input for secure PWM/GPIO control,
SN74LVC2G14DBV +3V3 +3V3 C5

protecting the logic circuit from DC motor noise. Protected 3.3V half-duplex transceiver stage (up to 500 kbps) D4

UART N°2 activity LED indicators (pulse stretcher)

Protected Half-Duplex RS-485

Buffer LVC Interface (Protected UART)

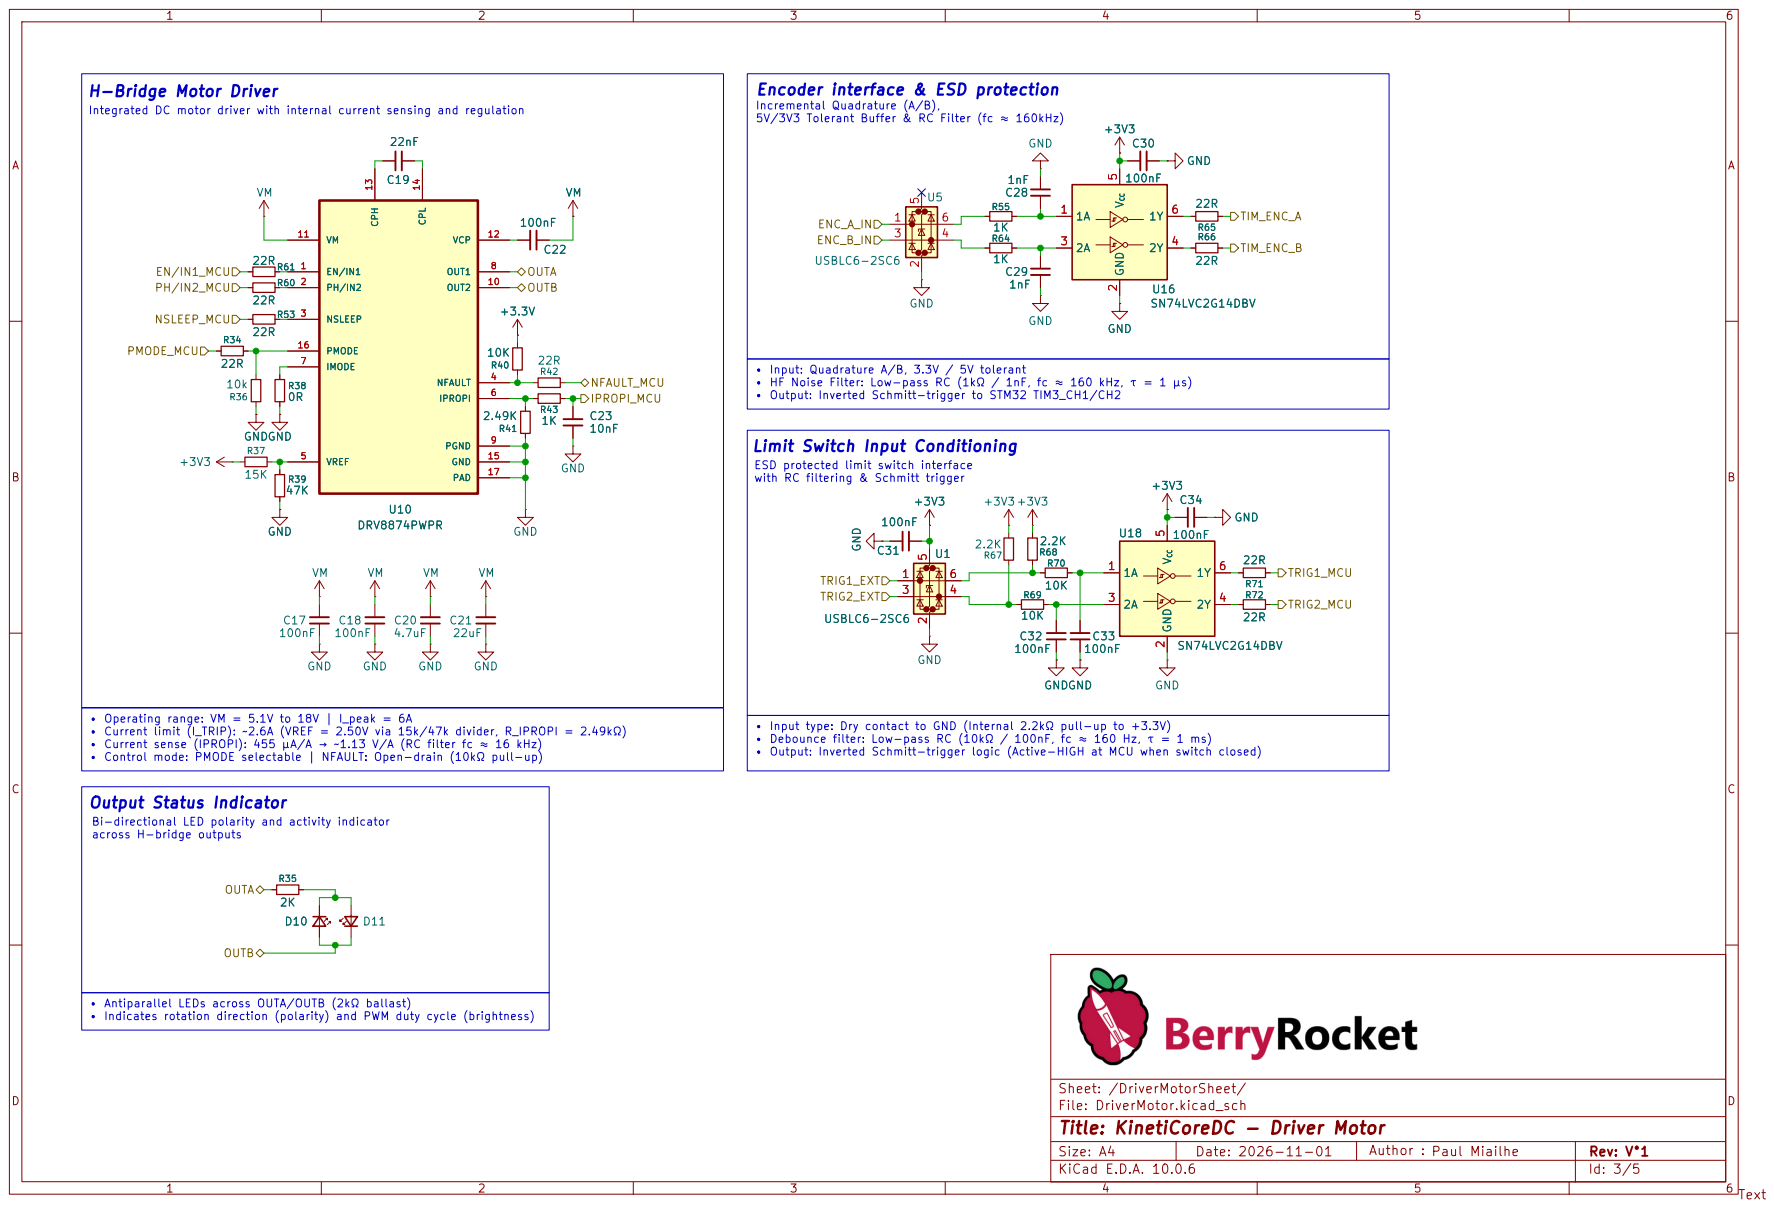
[picture p15: page 3]

H-Bridge Motor Driver
Integrated DC motor driver with internal current sensing and regulation

Encoder interface & ESD protection
Incremental Quadrature (A/B),
5V/3V3 Tolerant Buffer & RC Filter (fc ≈ 160kHz)

Limit Switch Input Conditioning

Sheet: /DriverMotorSheet/
File: DriverMotor.kicad_sch
Title: KinetiCoreDC - Driver Motor

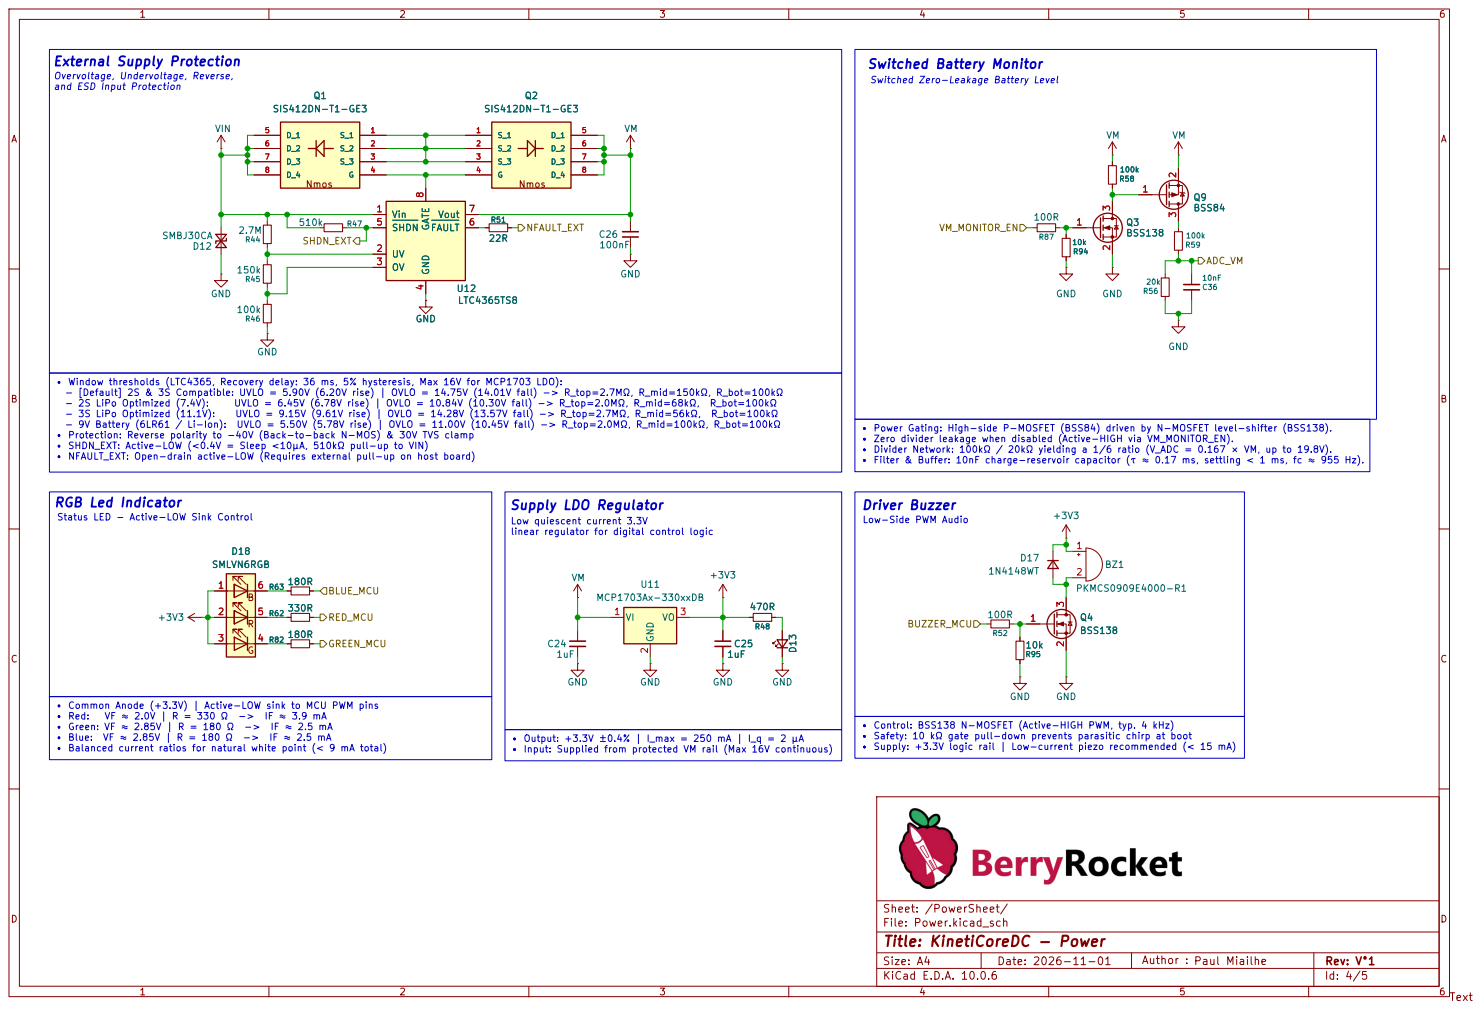
[picture p16: page 4]

Low-Side PWM Audio External Supply Protection

Low quiescent current 3.3V
linear regulator for digital control logic

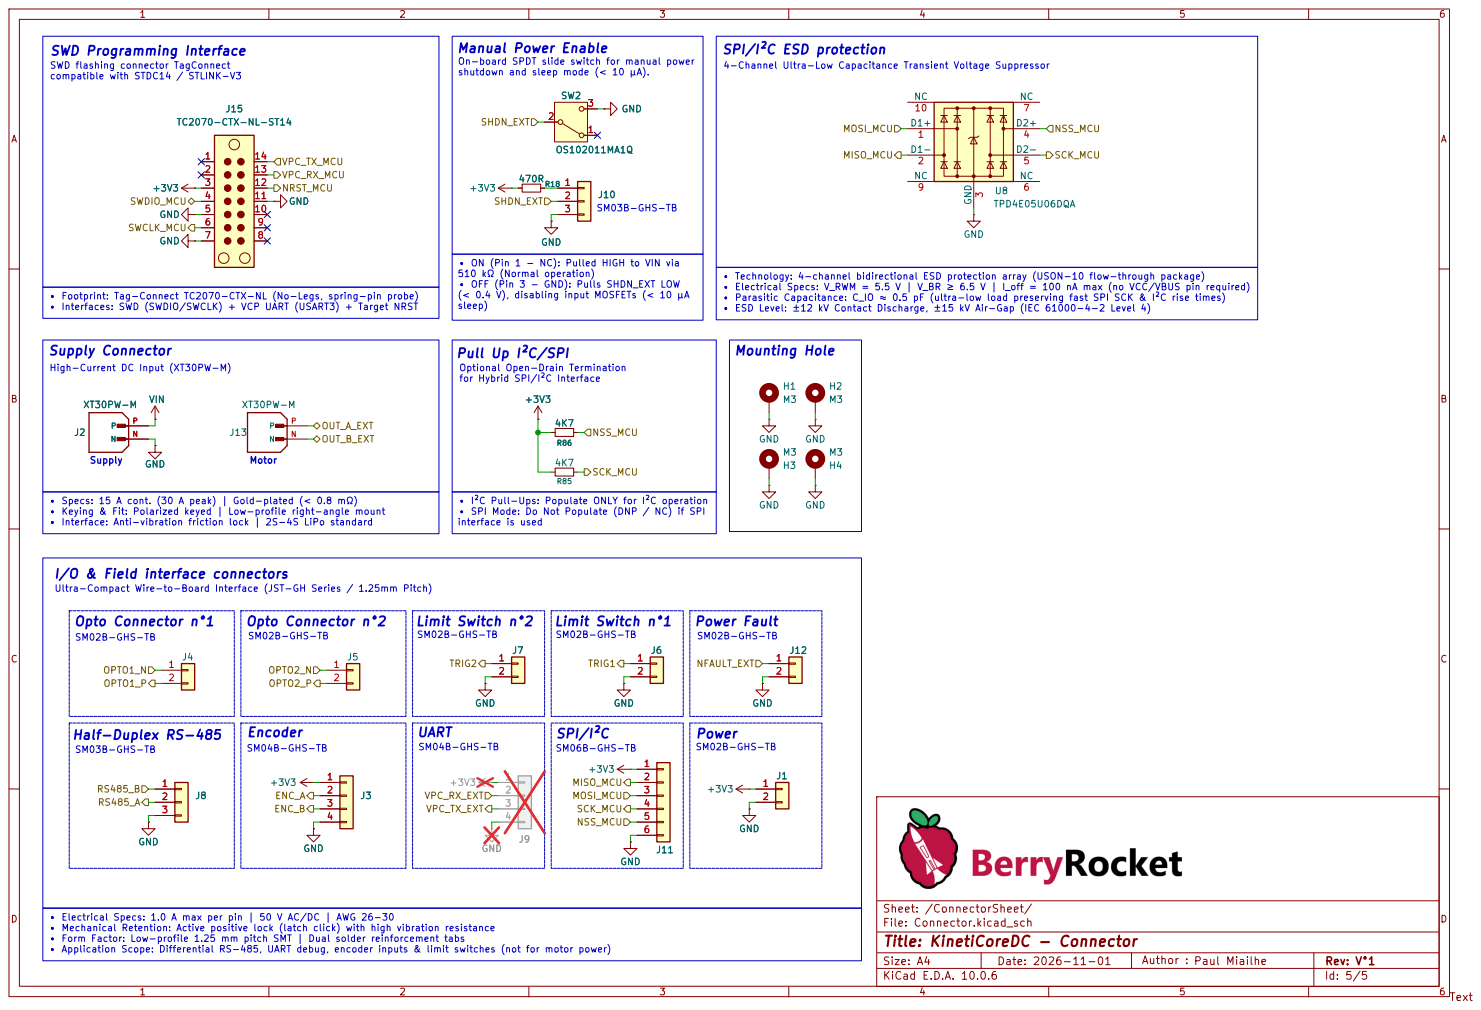
[picture p17: page 5]

for Hybrid SPI/I²C Interface SWD Programming Interface
SWD flashing connector TagConnect

Manual Power Enable
SM03B-GHS-TB On-board SPDT slide switch for manual power shutdown and sleep mode (< 10 µA).
compatible with STDC14 / STLINK-V3 Opto Connector n°1

SPI/I²C ESD protection
4-Channel Ultra-Low Capacitance Transient Voltage Suppressor

interface is used • ON (Pin 1 - NC): Pulled HIGH to VIN via 510 kΩ (Normal operation) • OFF (Pin 3 - GND): Pulls SHDN_EXT LOW

(< 0.4 V), disabling input MOSFETs (< 10 µA

High-Current DC Input (XT30PW-M)

Pull Up I²C/SPI SM04B-GHS-TB

Optional Open-Drain Termination

I/O & Field interface connectors
Ultra-Compact Wire-to-Board Interface (JST-GH Series / 1.25mm Pitch)

SM06B-GHS-TB SPI/I²C
