axpaul/KinetiCoreDC/KinetiCoreDC.kicad_pcb

## KiCad design KinetiCoreDC.kicad_pcb (2026-11-13)

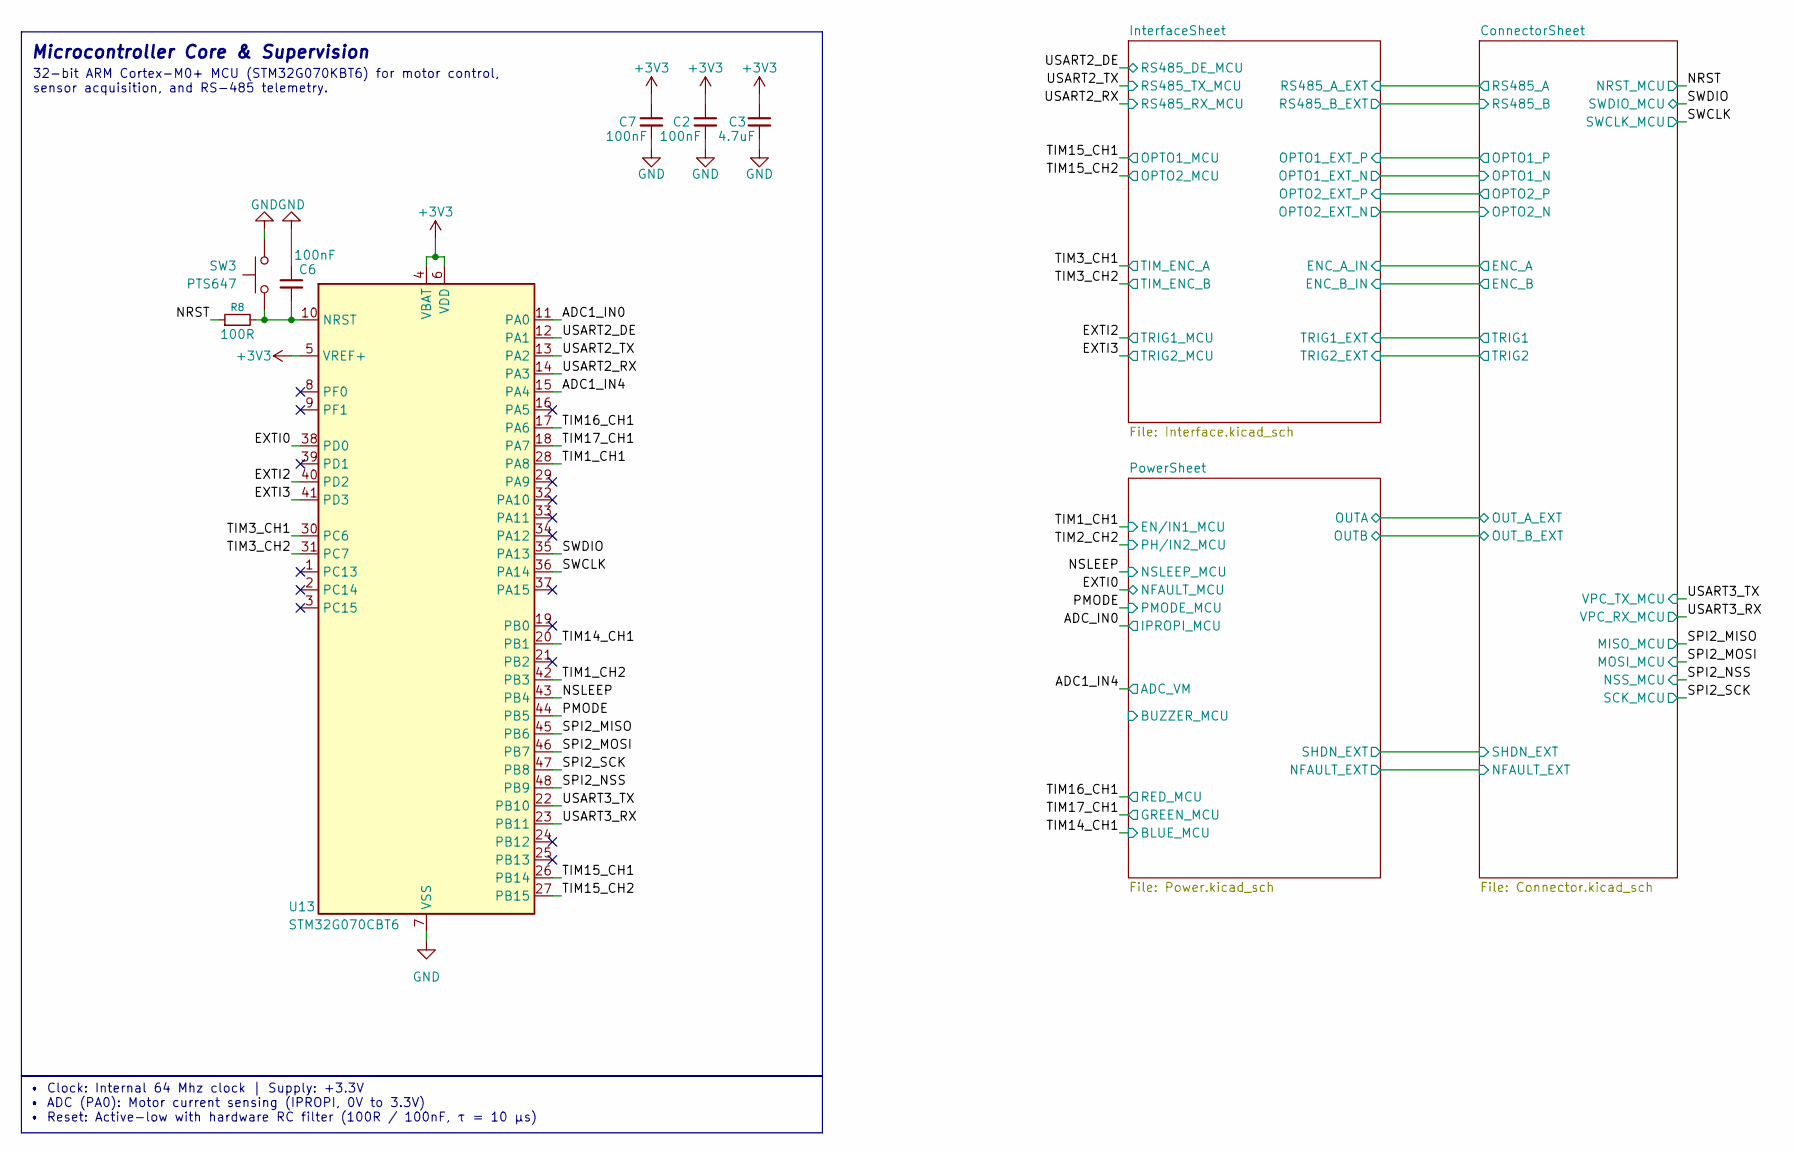
[picture p18: schematic KinetiCoreDC.kicad_sch, KinetiCoreDC - Main]

Parts:
C2, C6, C7: 100nF; C_0603_1608Metric
C3: 4.7uF; C_0603_1608Metric
R8: 100R; R_0603_1608Metric
SW3: PTS647; SW_SPST_PTS647_Sx38
U13: STM32G070CBT6; LQFP-48_7x7mm_P0.5mm

Connections:
+3V3: C2.1, C3.1, C7.1, U13.4 (VBAT), U13.5 (VREF+), U13.6 (VDD); also elsewhere on the board
/ADC1_IN0: U13.11 (PA0)
/ADC1_IN4: U13.15 (PA4); also elsewhere on the board
/EXTI0: U13.38 (PD0); also elsewhere on the board
/EXTI2: U13.40 (PD2); also elsewhere on the board
/EXTI3: U13.41 (PD3); also elsewhere on the board
/NRST: R8.1; also elsewhere on the board
/NSLEEP: U13.43 (PB4); also elsewhere on the board
/OE_VCP: U13.37 (PA15)
/PMODE: U13.44 (PB5); also elsewhere on the board
/SPI2_MISO: U13.45 (PB6); also elsewhere on the board
/SPI2_MOSI: U13.46 (PB7); also elsewhere on the board
/SPI2_NSS: U13.48 (PB9); also elsewhere on the board
/SPI2_SCK: U13.47 (PB8); also elsewhere on the board
/SWCLK: U13.36 (PA14); also elsewhere on the board
/SWDIO: U13.35 (PA13); also elsewhere on the board
/TIM1_CH1: U13.28 (PA8); also elsewhere on the board
/TIM1_CH2: U13.42 (PB3)
/TIM3_CH1: U13.30 (PC6); also elsewhere on the board
/TIM3_CH2: U13.31 (PC7); also elsewhere on the board
/TIM14_CH1: U13.20 (PB1); also elsewhere on the board
/TIM15_CH1: U13.26 (PB14); also elsewhere on the board
/TIM15_CH2: U13.27 (PB15); also elsewhere on the board
/TIM16_CH1: U13.17 (PA6); also elsewhere on the board
/TIM17_CH1: U13.18 (PA7); also elsewhere on the board
/USART2_DE: U13.12 (PA1); also elsewhere on the board
/USART2_RX: U13.14 (PA3); also elsewhere on the board
/USART2_TX: U13.13 (PA2); also elsewhere on the board
/USART3_RX: U13.23 (PB11); also elsewhere on the board
/USART3_TX: U13.22 (PB10); also elsewhere on the board
/VM_MONITOR_EN: U13.16 (PA5)
GND: C2.2, C3.2, C6.2, C7.2, SW3.1, U13.7 (VSS); also elsewhere on the board
unnamed: C6.1, R8.2, SW3.2, U13.10 (NRST)

Notes on the sheet:
Microcontroller Core & Supervision
32-bit ARM Cortex-M0+ MCU (STM32G070KBT6) for motor control, sensor acquisition, and RS-485 telemetry.
• Clock: Internal 64 Mhz clock | Supply: +3.3V • ADC (PA0): Motor current sensing (IPROPI, 0V to 3.3V) • Reset: Active-low with hardware RC filter (100R / 100nF, τ = 10 µs)

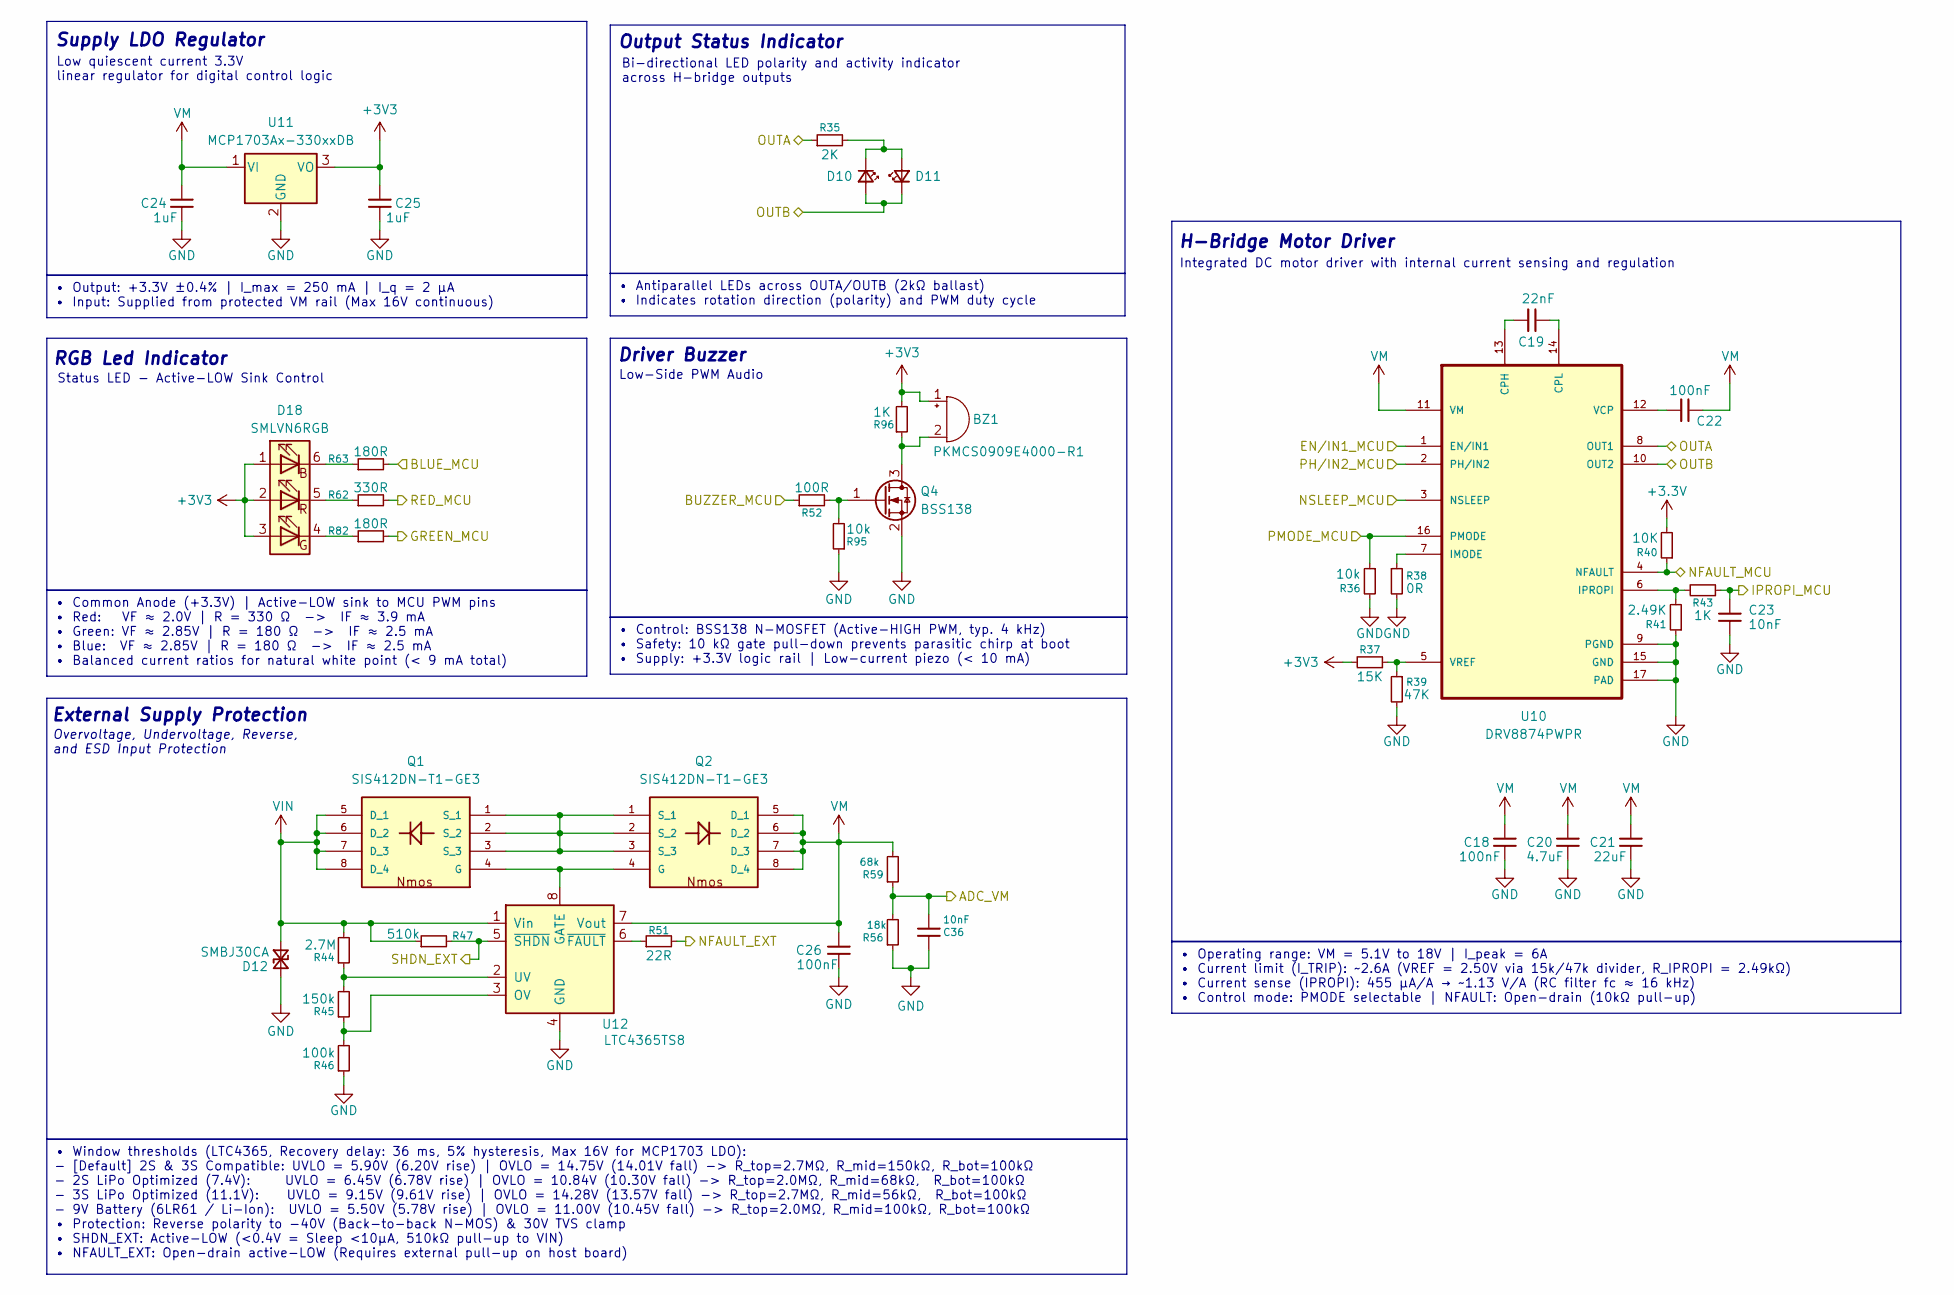
[picture p19: schematic Power.kicad_sch, KinetiCoreDC - Power]

Parts:
BZ1: PKMCS0909E4000-R1; Buzzer_Murata_PKMCS0909E
C18, C22, C26: 100nF; C_0603_1608Metric
C19: 22nF; C_0603_1608Metric
C20: 4.7uF; C_0805_2012Metric
C21: 22uF; C_0805_2012Metric
C23, C36: 10nF; C_0603_1608Metric
C24, C25: 1uF; C_0603_1608Metric
D10, D11: LED_Small; LED_0603_1608Metric
D12: SMBJ30CA; D_SMA
D18: SMLVN6RGB; LED_ROHM_SMLVN6
Q1, Q2: SIS412DN-T1-GE3; POWERPAK-1212-8; MOUSER_PART_NUMBER 781-SIS412DN-T1-GE3
Q4: BSS138; SOT-23
R35: 2K; R_0603_1608Metric
R36, R95: 10k; R_0603_1608Metric
R37: 15K; R_0603_1608Metric
R38: 0R; R_0603_1608Metric
R39: 47K; R_0603_1608Metric
R40: 10K; R_0603_1608Metric
R41: 2.49K; R_0603_1608Metric
R43, R96: 1K; R_0603_1608Metric
R44: 2.7M; R_0603_1608Metric
R45: 150k; R_0603_1608Metric
R46: 100k; R_0603_1608Metric
R47: 510k; R_0603_1608Metric
R51: 22R; R_0603_1608Metric
R52: 100R; R_0603_1608Metric
R56: 18k; R_0603_1608Metric
R59: 68k; R_0603_1608Metric
R62: 330R; R_0603_1608Metric
R63, R82: 180R; R_0603_1608Metric
U10: DRV8874PWPR; SOP65P640X120-17N
U11: MCP1703Ax-330xxDB; SOT-223-3_TabPin2
U12: LTC4365TS8; TSOT-23-8

Connections:
+3.3V: R40.2
+3V3: BZ1.1 (+), C25.1, D18.1 (BA), D18.2 (RA), D18.3 (GA), R37.2, R96.2, U11.3 (VO); also elsewhere on the board
/ADC1_IN4: C36.2, R56.2, R59.1; also elsewhere on the board
/ADC_IN0: C23.2, R43.1
/ConnectorSheet/NFAULT_EXT: R51.2; also elsewhere on the board
/ConnectorSheet/OUT_A_EXT: R35.1, U10.8 (OUT1); also elsewhere on the board
/ConnectorSheet/OUT_B_EXT: D10.2 (A), D11.1 (K), U10.10 (OUT2); also elsewhere on the board
/ConnectorSheet/SHDN_EXT: R47.2, U12.5 (~SHDN); also elsewhere on the board
/EXTI0: R40.1, U10.4 (NFAULT); also elsewhere on the board
/NSLEEP: U10.3 (NSLEEP); also elsewhere on the board
/PMODE: R36.1, U10.16 (PMODE); also elsewhere on the board
/PowerSheet/BUZZER_MCU: R52.1
/TIM1_CH1: U10.1 (EN/IN1); also elsewhere on the board
/TIM2_CH2: U10.2 (PH/IN2)
/TIM14_CH1: R63.2; also elsewhere on the board
/TIM16_CH1: R62.2; also elsewhere on the board
/TIM17_CH1: R82.2; also elsewhere on the board
GND: C18.2, C20.2, C21.2, C23.1, C24.2, C25.2, C26.2, C36.1, D12.2 (A2), Q4.2 (S), R36.2, R38.2, R39.2, R41.1, R46.1, R56.1, R95.1, U10.9 (PGND), U10.15 (GND), U10.17 (PAD), U11.2 (GND), U12.4 (GND); also elsewhere on the board
unnamed: BZ1.2 (-), Q4.3 (D), R96.1
unnamed: D10.1 (K), D11.2 (A), R35.2
unnamed: D18.6 (BK), R63.1
unnamed: D18.4 (GK), R82.1
unnamed: D18.5 (RK), R62.1
unnamed: Q1.4 (G), Q2.4 (G), U12.8 (GATE)
unnamed: Q1.1 (S_1), Q1.2 (S_2), Q1.3 (S_3), Q2.1 (S_1), Q2.2 (S_2), Q2.3 (S_3)
unnamed: Q4.1 (G), R52.2, R95.2
unnamed: C19.1, U10.13 (CPH)
unnamed: C19.2, U10.14 (CPL)
unnamed: R38.1, U10.7 (IMODE)
unnamed: R41.2, R43.2, U10.6 (IPROPI)
unnamed: C22.1, U10.12 (VCP)
unnamed: R37.1, R39.1, U10.5 (VREF)
unnamed: R45.1, R46.2, U12.3 (OV)
unnamed: R44.1, R45.2, U12.2 (UV)
unnamed: R51.1, U12.6 (~FAULT)
VIN: D12.1 (A1), Q1.5 (D_1), Q1.6 (D_2), Q1.7 (D_3), Q1.8 (D_4), R44.2, R47.1, U12.1 (Vin); also elsewhere on the board
VM: C18.1, C20.1, C21.1, C22.2, C24.1, C26.1, Q2.5 (D_1), Q2.6 (D_2), Q2.7 (D_3), Q2.8 (D_4), R59.2, U10.11 (VM), U11.1 (VI), U12.7 (Vout)

Notes on the sheet:
H-Bridge Motor Driver
RGB Led Indicator
Low quiescent current 3.3V linear regulator for digital control logic
Low-Side PWM Audio
Output Status Indicator
Driver Buzzer
Supply LDO Regulator
Overvoltage, Undervoltage, Reverse, and ESD Input Protection
Integrated DC motor driver with internal current sensing and regulation
External Supply Protection
Bi-directional LED polarity and activity indicator across H-bridge outputs
Status LED - Active-LOW Sink Control
• Control: BSS138 N-MOSFET (Active-HIGH PWM, typ. 4 kHz) • Safety: 10 kΩ gate pull-down prevents parasitic chirp at boot • Supply: +3.3V logic rail | Low-current piezo (< 10 mA)
• Window thresholds (LTC4365, Recovery delay: 36 ms, 5% hysteresis, Max 16V for MCP1703 LDO): - [Default] 2S & 3S Compatible: UVLO = 5.90V (6.20V rise) | OVLO = 14.75V (14.01V fall) -> R_top=2.7MΩ, R_mid=150kΩ, R_bot=100kΩ - 2S LiPo Optimized (7.4V): UVLO = 6.45V (6.78V rise) | OVLO = 10.84V (10.30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
• Output: +3.3V ±0.4% | I_max = 250 mA | I_q = 2 µA • Input: Supplied from protected VM rail (Max 16V continuous)
• Antiparallel LEDs across OUTA/OUTB (2kΩ ballast) • Indicates rotation direction (polarity) and PWM duty cycle
• Operating range: VM = 5.1V to 18V | I_peak = 6A • Current limit (I_TRIP): ~2.6A (VREF = 2.50V via 15k/47k divider, R_IPROPI = 2.49kΩ) • Current sense (IPROPI): 455 µA/A → ~1.13 V/A (RC filter fc ≈ 16 kHz) • Control mode: PMODE selectable | NFAULT: Open-drain (10kΩ pull-up)
• Common Anode (+3.3V) | Active-LOW sink to MCU PWM pins • Red: VF ≈ 2.0V | R = 330 Ω -> IF ≈ 3.9 mA • Green: VF ≈ 2.85V | R = 180 Ω -> IF ≈ 2.5 mA • Blue: VF ≈ 2.85V | R = 180 Ω -> IF ≈ 2.5 mA • Balanced current ratios for natural white point (< 9 mA total)

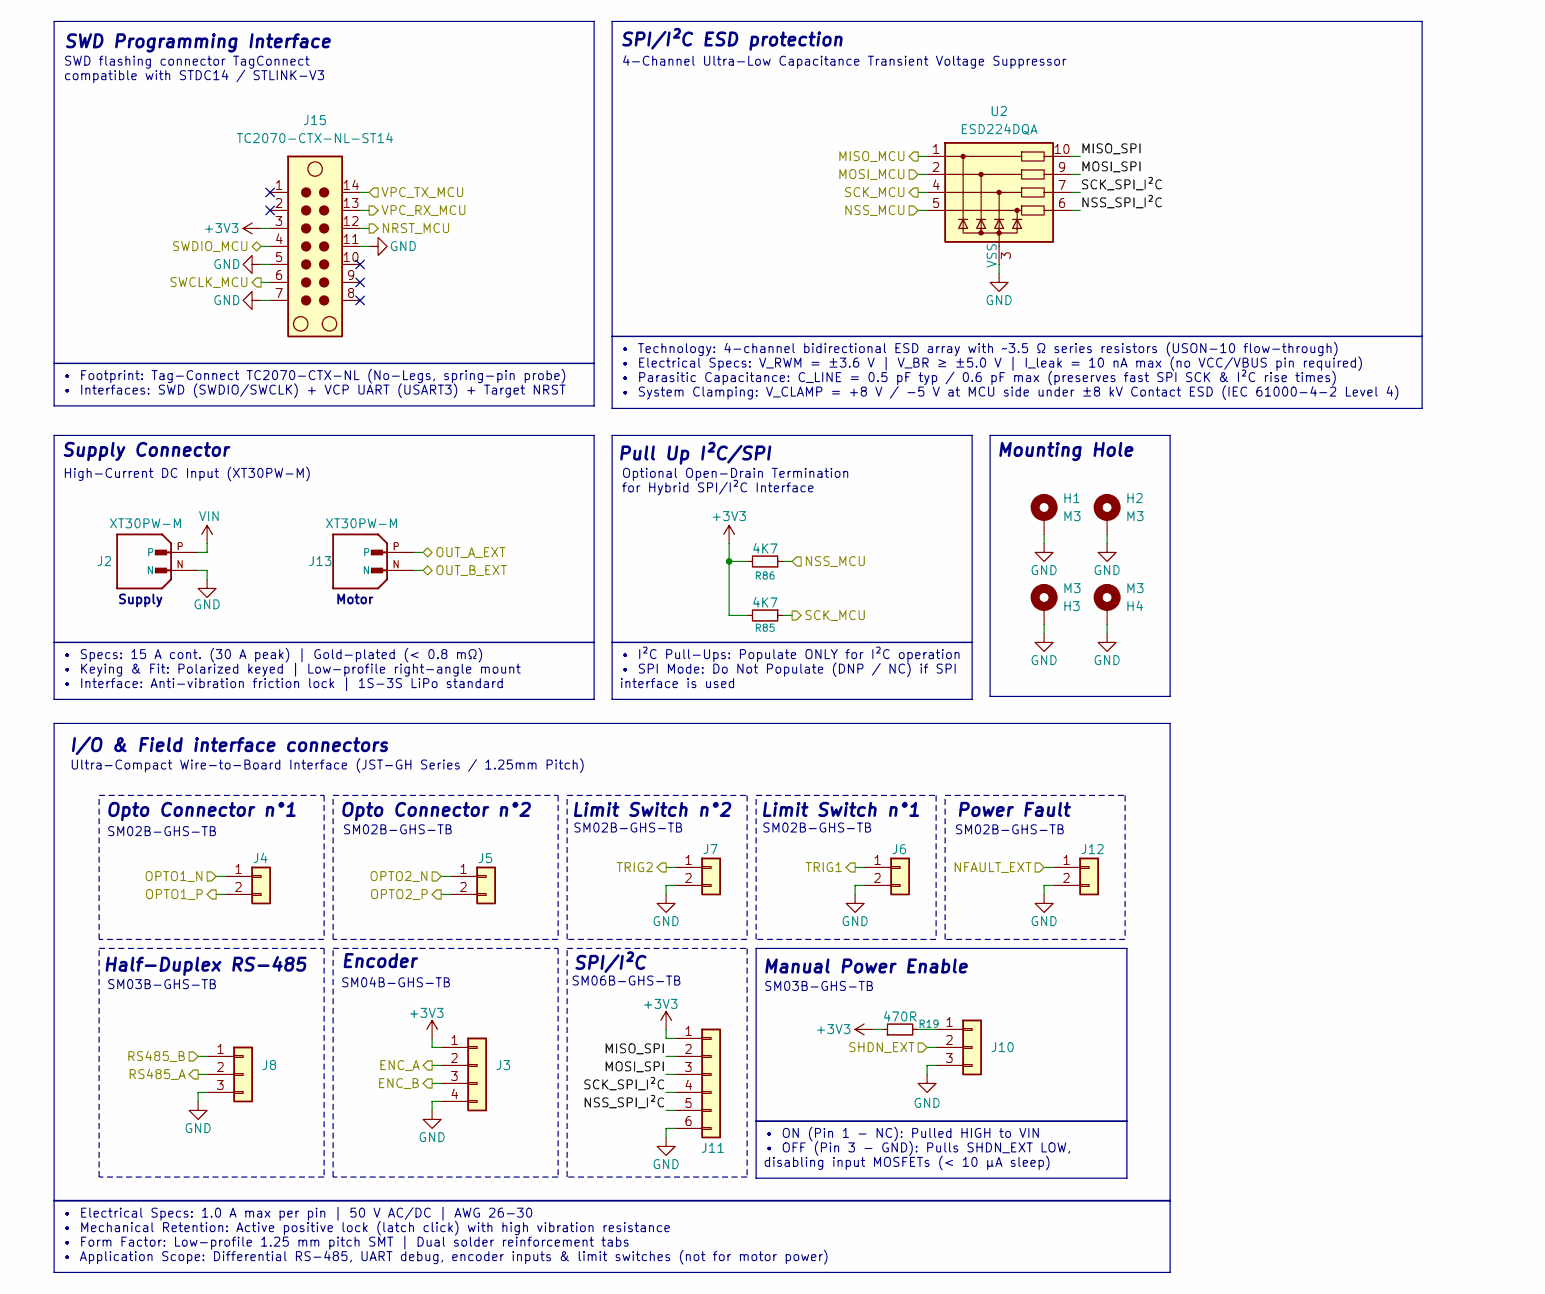
[picture p20: schematic Connector.kicad_sch, KinetiCoreDC - Connector]

Parts:
H1, H2, H3, H4: M3; MountingHole_3.2mm_M3_DIN965_Pad_TopBottom
J2, J13: XT30PW-M; AMASS_XT30PW-M; PARTREV 1.2
J3: SM04B-GHS-TB; JST_GH_SM04B-GHS-TB_1x04-1MP_P1.25mm_Horizontal
J4, J6, J7, J12: SM02B-GHS-TB; JST_GH_SM02B-GHS-TB_1x02-1MP_P1.25mm_Horizontal
J5: BM02B-GHS-TBT; JST_GH_SM02B-GHS-TB_1x02-1MP_P1.25mm_Horizontal
J8, J10: SM03B-GHS-TB; JST_GH_SM03B-GHS-TB_1x03-1MP_P1.25mm_Horizontal
J11: Conn_01x06; JST_GH_SM06B-GHS-TB_1x06-1MP_P1.25mm_Horizontal
J15: TC2070-CTX-NL-ST14; Tag-Connect_TC2070-IDC-FP_2x07_P1.27mm_Vertical
R19: 470R; R_0603_1608Metric
R85, R86: 4K7; R_0603_1608Metric
U2: ESD224DQA; Diodes_UDFN-10_1x2.5mm_P0.5mm

Connections:
+3V3: J3.1, J11.1, J15.3, R19.1, R85.2, R86.2; also elsewhere on the board
/ConnectorSheet/ENC_A: J3.2; also elsewhere on the board
/ConnectorSheet/ENC_B: J3.3; also elsewhere on the board
/ConnectorSheet/MISO_SPI: J11.2, U2.10
/ConnectorSheet/MOSI_SPI: J11.3, U2.9
/ConnectorSheet/NFAULT_EXT: J12.1; also elsewhere on the board
/ConnectorSheet/NSS_SPI_I²C: J11.5, U2.6
/ConnectorSheet/OPTO1_N: J4.1; also elsewhere on the board
/ConnectorSheet/OPTO1_P: J4.2; also elsewhere on the board
/ConnectorSheet/OPTO2_N: J5.1; also elsewhere on the board
/ConnectorSheet/OPTO2_P: J5.2; also elsewhere on the board
/ConnectorSheet/OUT_A_EXT: J13.P; also elsewhere on the board
/ConnectorSheet/OUT_B_EXT: J13.N; also elsewhere on the board
/ConnectorSheet/RS485_A: J8.2; also elsewhere on the board
/ConnectorSheet/RS485_B: J8.1; also elsewhere on the board
/ConnectorSheet/SCK_SPI_I²C: J11.4, U2.7
/ConnectorSheet/SHDN_EXT: J10.2; also elsewhere on the board
/ConnectorSheet/TRIG1: J6.1; also elsewhere on the board
/ConnectorSheet/TRIG2: J7.1; also elsewhere on the board
/NRST: J15.12; also elsewhere on the board
/SPI2_MISO: U2.1; also elsewhere on the board
/SPI2_MOSI: U2.2; also elsewhere on the board
/SPI2_NSS: R86.1, U2.5; also elsewhere on the board
/SPI2_SCK: R85.1, U2.4; also elsewhere on the board
/SWCLK: J15.6; also elsewhere on the board
/SWDIO: J15.4; also elsewhere on the board
/USART3_RX: J15.13; also elsewhere on the board
/USART3_TX: J15.14; also elsewhere on the board
GND: H1.1 (1_1), H2.1 (1_1), H3.1 (1_1), H4.1 (1_1), J2.N, J3.4, J6.2, J7.2, J8.3, J10.3, J11.6, J12.2, J15.5, J15.7, J15.11, U2.3 (VSS), U2.8 (VSS); also elsewhere on the board
unnamed: J10.1, R19.2
VIN: J2.P; also elsewhere on the board

Notes on the sheet:
Limit Switch n°1
Pull Up I²C/SPI
SM03B-GHS-TB
Encoder
Power Fault
I/O & Field interface connectors
Optional Open-Drain Termination for Hybrid SPI/I²C Interface
SPI/I²C
Opto Connector n°1
SM06B-GHS-TB
High-Current DC Input (XT30PW-M)
SM02B-GHS-TB
SWD flashing connector TagConnect compatible with STDC14 / STLINK-V3
4-Channel Ultra-Low Capacitance Transient Voltage Suppressor
Limit Switch n°2
Opto Connector n°2
Mounting Hole
SM04B-GHS-TB
Manual Power Enable
Ultra-Compact Wire-to-Board Interface (JST-GH Series / 1.25mm Pitch)
SPI/I²C ESD protection
Half-Duplex RS-485
Supply Connector
SWD Programming Interface
Supply
Motor
• Footprint: Tag-Connect TC2070-CTX-NL (No-Legs, spring-pin probe) • Interfaces: SWD (SWDIO/SWCLK) + VCP UART (USART3) + Target NRST
• Electrical Specs: 1.0 A max per pin | 50 V AC/DC | AWG 26-30 • Mechanical Retention: Active positive lock (latch click) with high vibration resistance • Form Factor: Low-profile 1.25 mm pitch SMT | Dual solder reinforcement tabs • Application Scope: Differential RS-485, UART debug, encoder inputs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
• Specs: 15 A cont. (30 A peak) | Gold-plated (< 0.8 mΩ) • Keying & Fit: Polarized keyed | Low-profile right-angle mount • Interface: Anti-vibration friction lock | 1S-3S LiPo standard
• Technology: 4-channel bidirectional ESD array with ~3.5 Ω series resistors (USON-10 flow-through) • Electrical Specs: V_RWM = ±3.6 V | V_BR ≥ ±5.0 V | I_leak = 10 nA max (no VCC/VBUS pin required) • Parasitic Capacitance: C_LINE = 0.5 pF typ / 0.6 pF max (preserves fast SPI SCK & I²C rise times) 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
• I²C Pull-Ups: Populate ONLY for I²C operation • SPI Mode: Do Not Populate (DNP / NC) if SPI interface is used
• ON (Pin 1 - NC): Pulled HIGH to VIN • OFF (Pin 3 - GND): Pulls SHDN_EXT LOW, disabling input MOSFETs (< 10 µA sleep)

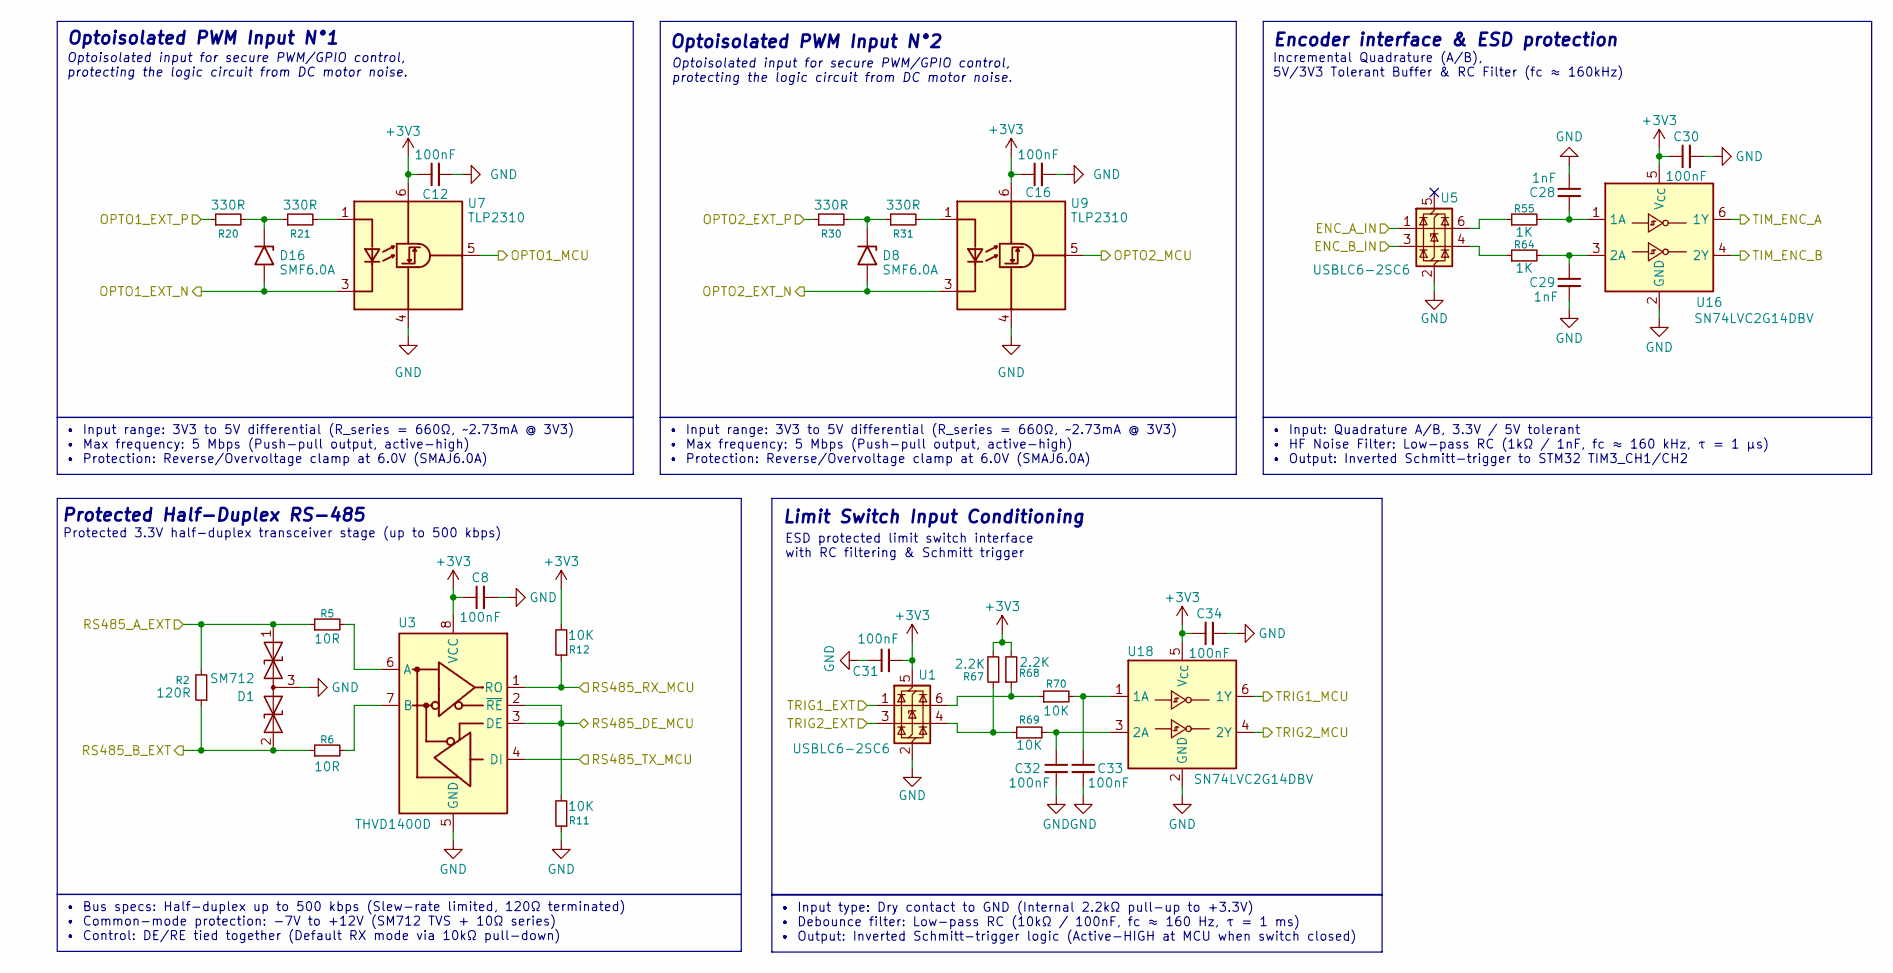
[picture p21: schematic Interface.kicad_sch, KinetiCoreDC - Interface]

Parts:
C8, C12, C16, C30, C31, C32, C33, C34: 100nF; C_0603_1608Metric
C28, C29: 1nF; C_0603_1608Metric
D1: SM712; SOT-23
D8, D16: SMF6.0A; D_SOD-123F
R2: 120R; R_0603_1608Metric
R5, R6: 10R; R_0603_1608Metric
R11, R12, R69, R70: 10K; R_0603_1608Metric
R20, R21, R30, R31: 330R; R_0603_1608Metric
R55, R64: 1K; R_0603_1608Metric
R67, R68: 2.2K; R_0603_1608Metric
U1, U5: USBLC6-2SC6; SOT-23-6
U3: THVD1400D; SOIC-8_3.9x4.9mm_P1.27mm
U7, U9: TLP2310; SO-5-6_4.55x3.7mm_P1.27mm
U16, U18: SN74LVC2G14DBV; SOT-23-6

Connections:
+3V3: C8.1, C12.1, C16.1, C30.1, C31.1, C34.1, R12.2, R67.2, R68.2, U1.5 (VBUS), U3.8 (VCC), U7.6 (VDD), U9.6 (VDD), U16.5 (V_{CC}), U18.5 (V_{CC}); also elsewhere on the board
/ConnectorSheet/ENC_A: U5.1 (I/O1); also elsewhere on the board
/ConnectorSheet/ENC_B: U5.3 (I/O2); also elsewhere on the board
/ConnectorSheet/OPTO1_N: D16.2 (A2), U7.3 (K); also elsewhere on the board
/ConnectorSheet/OPTO1_P: R20.1; also elsewhere on the board
/ConnectorSheet/OPTO2_N: D8.2 (A2), U9.3 (K); also elsewhere on the board
/ConnectorSheet/OPTO2_P: R30.1; also elsewhere on the board
/ConnectorSheet/RS485_A: D1.1 (A1), R2.2, R5.1; also elsewhere on the board
/ConnectorSheet/RS485_B: D1.2 (A2), R2.1, R6.1; also elsewhere on the board
/ConnectorSheet/TRIG1: U1.3 (I/O2); also elsewhere on the board
/ConnectorSheet/TRIG2: U1.1 (I/O1); also elsewhere on the board
/EXTI2: U18.6 (1Y); also elsewhere on the board
/EXTI3: U18.4 (2Y); also elsewhere on the board
/TIM3_CH1: U16.6 (1Y); also elsewhere on the board
/TIM3_CH2: U16.4 (2Y); also elsewhere on the board
/TIM15_CH1: U7.5 (VO); also elsewhere on the board
/TIM15_CH2: U9.5 (VO); also elsewhere on the board
/USART2_DE: R11.2, U3.2 (~RE), U3.3 (DE); also elsewhere on the board
/USART2_RX: R12.1, U3.1 (RO); also elsewhere on the board
/USART2_TX: U3.4 (DI); also elsewhere on the board
GND: C8.2, C12.2, C16.2, C28.1, C29.1, C30.2, C31.2, C32.1, C33.1, C34.2, D1.3 (common), R11.1, U1.2 (GND), U3.5 (GND), U5.2 (GND), U7.4 (GND), U9.4 (GND), U16.2 (GND), U18.2 (GND); also elsewhere on the board
unnamed: D8.1 (A1), R30.2, R31.1
unnamed: D16.1 (A1), R20.2, R21.1
unnamed: R55.1, U5.6 (I/O1)
unnamed: R64.1, U5.4 (I/O2)
unnamed: R67.1, R69.1, U1.4 (I/O2)
unnamed: R68.1, R70.1, U1.6 (I/O1)
unnamed: R5.2, U3.6 (A)
unnamed: R6.2, U3.7 (B)
unnamed: R21.2, U7.1 (A)
unnamed: R31.2, U9.1 (A)
unnamed: C28.2, R55.2, U16.1 (1A)
unnamed: C29.2, R64.2, U16.3 (2A)
unnamed: C33.2, R70.2, U18.1 (1A)
unnamed: C32.2, R69.2, U18.3 (2A)

Notes on the sheet:
Optoisolated PWM Input N°1
Protected 3.3V half-duplex transceiver stage (up to 500 kbps)
Optoisolated input for secure PWM/GPIO control, protecting the logic circuit from DC motor noise.
Incremental Quadrature (A/B), 5V/3V3 Tolerant Buffer & RC Filter (fc ≈ 160kHz)
Encoder interface & ESD protection
Limit Switch Input Conditioning
ESD protected limit switch interface with RC filtering & Schmitt trigger
Optoisolated PWM Input N°2
Protected Half-Duplex RS-485
• Input: Quadrature A/B, 3.3V / 5V tolerant • HF Noise Filter: Low-pass RC (1kΩ / 1nF, fc ≈ 160 kHz, τ = 1 µs) • Output: Inverted Schmitt-trigger to STM32 TIM3_CH1/CH2
• Bus specs: Half-duplex up to 500 kbps (Slew-rate limited, 120Ω terminated) • Common-mode protection: -7V to +12V (SM712 TVS + 10Ω series) • Control: DE/RE tied together (Default RX mode via 10kΩ pull-down)
• Input type: Dry contact to GND (Internal 2.2kΩ pull-up to +3.3V) • Debounce filter: Low-pass RC (10kΩ / 100nF, fc ≈ 160 Hz, τ = 1 ms) • Output: Inverted Schmitt-trigger logic (Active-HIGH at MCU when switch closed)
• Input range: 3V3 to 5V differential (R_series = 660Ω, ~2.73mA @ 3V3) • Max frequency: 5 Mbps (Push-pull output, active-high) • Protection: Reverse/Overvoltage clamp at 6.0V (SMAJ6.0A)

Board: 2 copper layers, 104 parts (12 on the bottom side), 82 nets, no tracks yet.
