axpaul/KinetiCoreDC/KinetiCoreDC.ioc

Mcu.UserName=STM32G070CBTx
PA0.GPIO_Label=IPROPI
PA0.Signal=ADC1_IN0
PA1.GPIO_Label=RS485_DE
PA1.Signal=USART2_DE
PA13.Signal=SYS_SWDIO
PA14-BOOT0.Signal=SYS_SWCLK
PA15.GPIO_Label=OE_VCP
PA15.Signal=GPIO_Output
PA2.GPIO_Label=RS485_TX
PA2.Signal=USART2_TX
PA3.GPIO_Label=RS485_RX
PA3.Signal=USART2_RX
PA4.GPIO_Label=ADC_VM
PA4.Signal=ADC1_IN4
PA5.GPIO_Label=VM_MONITOR_EN
PA5.Signal=GPIO_Output
PA6.GPIO_Label=RED_RGB
PA6.Signal=S_TIM16_CH1
PA7.GPIO_Label=GREEN_RGB
PA7.Signal=S_TIM17_CH1
PA8.GPIO_Label=EN/IN1_DRV
PA8.Signal=S_TIM1_CH1
PB1.GPIO_Label=BLUE_RGB
PB1.Signal=S_TIM14_CH1
PB10.GPIO_Label=VCP_TX
PB10.Signal=USART3_TX
PB11.GPIO_Label=VCP_RX
PB11.Signal=USART3_RX
PB14.GPIO_Label=OPTO1
PB14.Signal=S_TIM15_CH1
PB15.GPIO_Label=OPTO2
PB15.Signal=S_TIM15_CH2
PB3.Signal=S_TIM1_CH2
PB4.GPIO_Label=NSLEEP
PB4.Signal=GPIO_Output
PB5.GPIO_Label=PMODE
PB5.Signal=GPIO_Output
PB6.Signal=SPI2_MISO
PB7.Signal=SPI2_MOSI
PB8.Signal=SPI2_SCK
PB9.Signal=SPI2_NSS
PC6.GPIO_Label=TIM_ENC_A
PC6.Signal=S_TIM3_CH1
PC7.GPIO_Label=TIM_ENC_B
PC7.Signal=S_TIM3_CH2
PD0.GPIO_Label=NFAULT_DRV
PD0.Signal=GPXTI0
PD2.GPIO_Label=TRIG1
PD2.Signal=GPXTI2
PD3.GPIO_Label=TRIG2
PD3.Signal=GPXTI3
