axpaul/KinetiCoreDC/(commit log)

2026-10-11 Initial commit: KiCad project KinetiCoreDC
2026-10-11 git commit -m "Add RS485 transceiver circuitry"
2026-10-12 Update schematics: limit switches, debug TC2070 and power supply stage
2026-10-13 feat: add driver component and some correction
2026-10-13 feat: integrate DRV8874 H-bridge stage with current sensing and polarity LEDs
2026-10-13 fix(motor): resolve DRV8874 pin configuration, add IPROPI RC filter and status LEDs
2026-10-14 feat(hw): add asymmetrical RC pulse stretcher for UART TX/RX activity LEDs
2026-10-15 feat:add power sheat
2026-10-16 feat: add quadrature encoder interface
2026-10-18 feat: add LTC4365 protection circuit and 3.3V logic LDO
2026-10-18 feat: add standardized functional notes across all schematic sheets
2026-10-18 fix : Fix the resitor value for leds
2026-10-19 wip(sch): draft JST-XH and solder pad connector interfaces
2026-10-24 refactor(schematic): migrate MCU to LQFP48 and finalize pinout mapping
2026-10-25 feat: add XT30PW-M DC input connector with functional notes
2026-10-26 feat : add SMLVN6RGB status LED stage with balanced 3.3V ballast resistors
2026-10-27 feat: switch to JST-GH connectors and add TPD4E05U06 TVS protection for SPI/I2C
2026-10-28 feat: add SPI connector and I²c pull up for magnetic encoder
2026-10-29 feat: finalize STM32G070CBT6 LQFP48 pinout and peripheral mapping
2026-10-29 feat: update pinout STM32 cubeMX
2026-11-01 wip : start board layout and component placement
2026-11-01 docs(synoptic): update KinetiCoreDC block diagram with accurate pinout, connectors, and power path
2026-11-03 feat(rcc): add 16MHz HSE crystal oscillator circuit on PF0/PF1
2026-11-09 Reduce electronic function (Buffer uart) on the board to optimize the PCB surface area.
